Xinyuan-LilyGO/T-Display-P4/firmware/[T-Display-P4][edge_agent]/README.md

# Firmware Modification Log

## 202606021556
### Changed firmware
- `[T-Display-P4_v1.0][edge_agent]_firmware_202606021556`
### Change content
- 更新edge_agent版本

## 202605291655
### Changed firmware
- `[T-Display-P4_v1.0][edge_agent]_firmware_202605291655`
### Change content
- 新增触摸控制

## 202605211541
### Changed firmware
- `[T-Display-P4_v1.0][edge_agent]_firmware_202605211541.bin`
### Change content
- 添加自动识别屏幕类型
- 新增es8311模块、2个i2c总线、1个uart（用于gps gnss）、1个i2s

## 202605080938
### Changed firmware
- `[T-Display-P4_v1.0][edge_agent][hi8561][ov2710]_firmware_202605080938`
- `[T-Display-P4_v1.0][edge_agent][rm69a10][ov2710]_firmware_202605080938`
### Change content
- 初始版本
