Xinyuan-LilyGO/T-Display-P4/firmware/[T-Display-P4-Keyboard][lvgl_9_ui]/README.md

# Firmware Modification Log

## 202604071529
### Changed firmware
- `[T-Display-P4_v1.0][T-Display-P4-Keyboard_v1.0][lvgl_9_ui][hi8561][ov2710]_firmware_202604071529`
- `[T-Display-P4_v1.0][T-Display-P4-Keyboard_v1.0][lvgl_9_ui][rm69a10][ov2710]_firmware_202604071529`
### Change content
- 更新最新测试版本

## 202510230957
### Changed firmware
- `[T-Display-P4-Keyboard][lvgl_9_ui][hi8561][ov2710]_firmware_202510230957`
- `[T-Display-P4-Keyboard][lvgl_9_ui][rm69a10][ov2710]_firmware_202510230957`
### Change content
- 将摄像头ppa操作的输出数据换为独立内存解决摄像头撕裂问题

## 202510151042
### Changed firmware
- `[T-Display-P4-Keyboard][lvgl_9_ui][hi8561][ov2710]_firmware_202510151042`
- `[T-Display-P4-Keyboard][lvgl_9_ui][rm69a10][ov2710]_firmware_202510151042`
### Change content
- 更新esp-idf v5.5.0版本
- 修复摄像头ppa裁剪错误问题
- 添加屏幕旋转使用ppa功能

## 202509261215
### Changed firmware
- `[T-Display-P4-Keyboard][lvgl_9_ui][hi8561][ov2710]_firmware_202509261215`
- `[T-Display-P4-Keyboard][lvgl_9_ui][rm69a10][ov2710]_firmware_202509261215`
### Change content
- 添加系统设备状态通知

## 202509151729
### Changed firmware
- `[T-Display-P4-Keyboard][lvgl_9_ui][hi8561][ov2710]_firmware_202509151729`
- `[T-Display-P4-Keyboard][lvgl_9_ui][rm69a10][ov2710]_firmware_202509151729`
### Change content
- 修改背光驱动芯片pwm频率为20khz，修复键盘背光啸叫声

## 202509101652
### Changed firmware
- `[T-Display-P4-Keyboard][lvgl_9_ui][hi8561][ov2710]_firmware_202509101652`
- `[T-Display-P4-Keyboard][lvgl_9_ui][rm69a10][ov2710]_firmware_202509101652`
### Change content
- 初始版本
