Xinyuan-LilyGO/T-Display-P4/main/examples/lvgl_9_ui/resource/t_display_p4_lvgl_9_ui_resource/music cover/Eagles - Hotel California (Live on MTV, 1994)_568x1232px.png

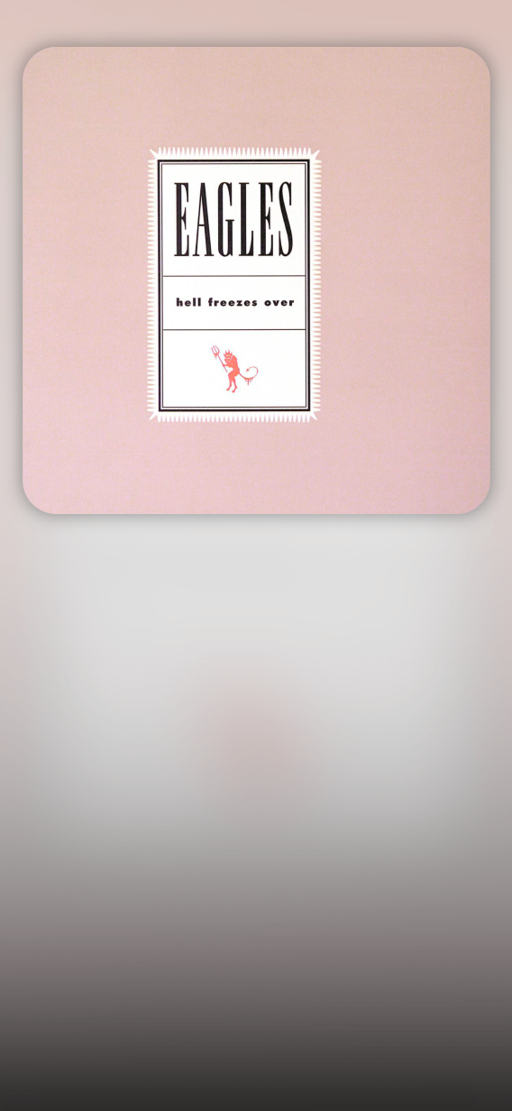
main/examples/lvgl_9_ui/resource/t_display_p4_lvgl_9_ui_resource/music cover/Eagles - Hotel California (Live on MTV, 1994)_568x1232px.png
