Xinyuan-LilyGO/T-Display-P4/main/examples/lvgl_9_ui/resource/t_display_p4_lvgl_9_ui_resource/wallpaper/wallpaper_3_540x1168px.png

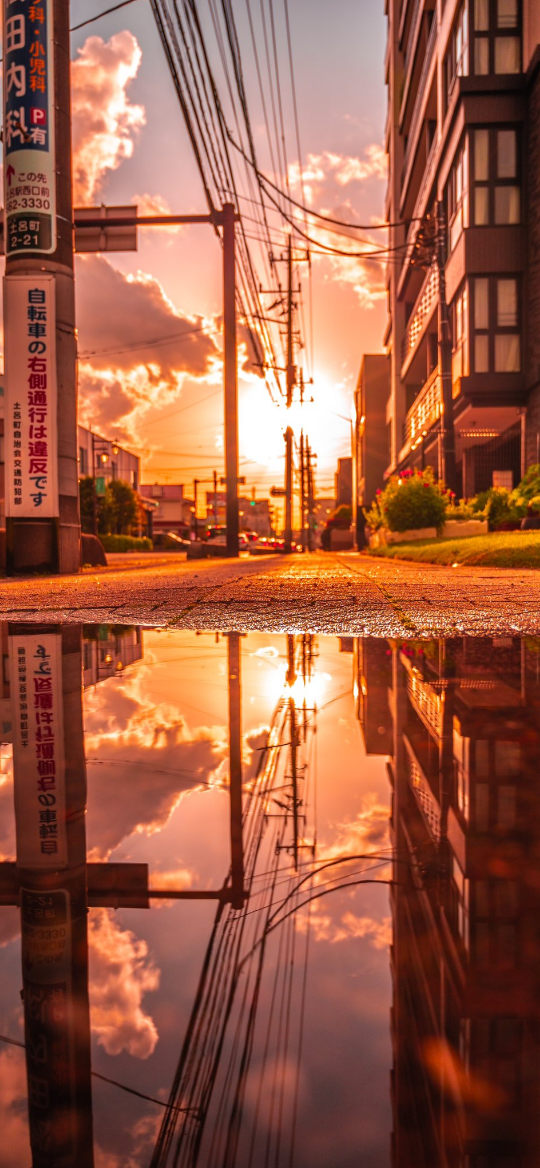
main/examples/lvgl_9_ui/resource/t_display_p4_lvgl_9_ui_resource/wallpaper/wallpaper_3_540x1168px.png
