Xinyuan-LilyGO/T-Display-P4/structure/K270.stp

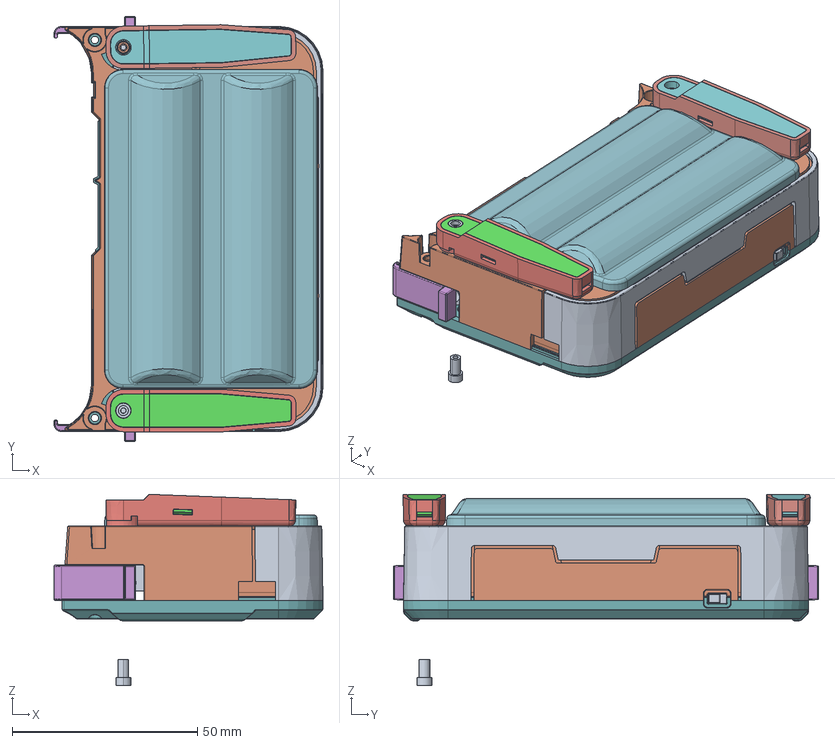
[picture p16: CAD file, 2026-11-02]
structure/K270.stp
72.6 x 114.7 x 51.6 mm
0-ALL_ASM_281_ASM_2_ASM_3_ASM_2_ASM
TOPCOPPER_TGVZ_1
BOTTOMCOPPER_TGVZ_1
TOPFPCSTIFFENER_TGVZ_1
BOTTOMFPCSTIFFENER_TGVZ_1
ANT-TH_KH-MMCX-KWE_MMCX-SMD_KH-_ASM
TOPCOPPER_TGVZ_1_1
BOTTOMCOPPER_TGVZ_1_1
TOPFPCSTIFFENER_TGVZ_1_1
BOTTOMFPCSTIFFENER_TGVZ_1_1
ANT-TH_KH-MMCX-KWE_MMCX-SMD__15_ASM
0-0019_ASM
020001_14_MIR_5_3
020002_12_MIR_2_5
