Xinyuan-LilyGO/T-Display-P4/structure/K270-STL/0-00.stl

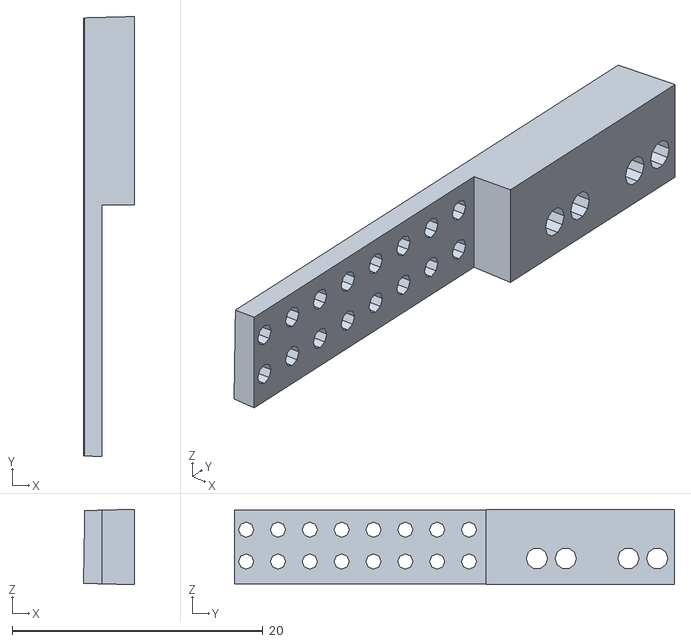
[picture p17: CAD file, 2026-11-02]
structure/K270-STL/0-00.stl
4.07 x 35.1 x 6.02
