Xinyuan-LilyGO/T-Display-P4/structure/T-Display-P4_V1.0_PCB.dxf

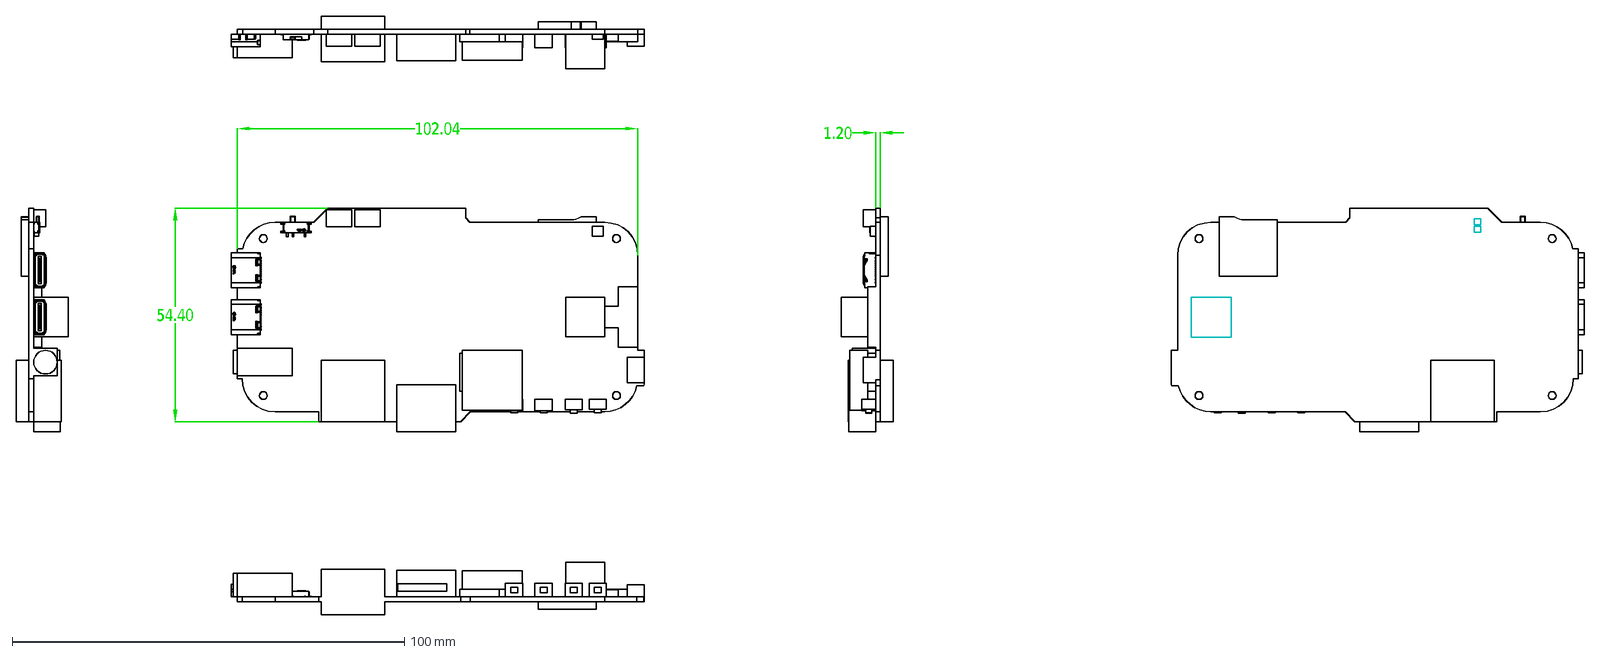
[picture p18: CAD file, 2026-10-16]
structure/T-Display-P4_V1.0_PCB.dxf
102.04
54.40
1.20
