Xinyuan-LilyGO/T-Display-P4/structure/H753.stp

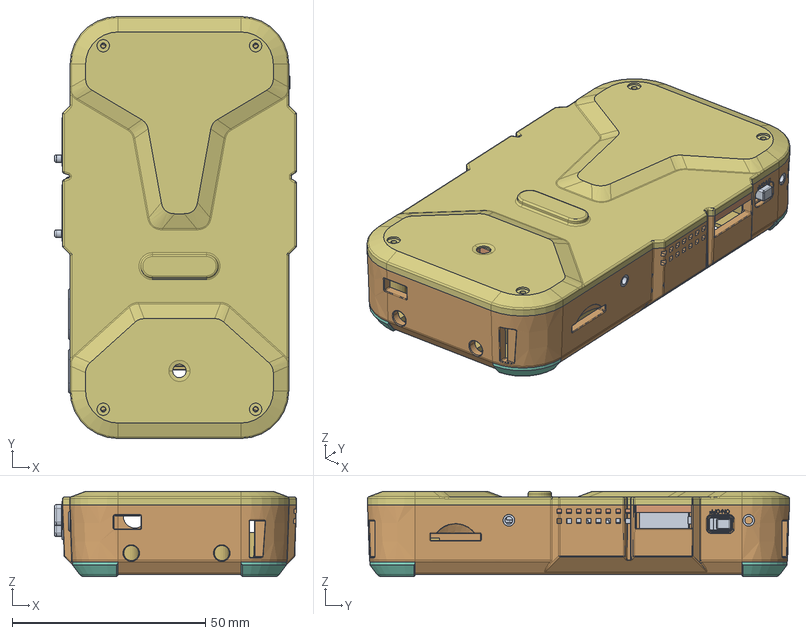
[picture p19: CAD file, 2026-06-24]
structure/H753.stp
62.6 x 109.1 x 22.1 mm
0-KEY_49_4_2_2_16
ADMI0DC85E9FFMCY_1_3
ADMI0DC85E9FFMCY_2_1
ADMI0DC85E9FFMCY_3_1
ADMI0DC85E9FFMCY_4_1
ADMI0DC85E9FFMCY_5_1
ADMI0DC85E9FFMCY_6_1
ADMI0DC85E9FFMCY_7_1
