Xinyuan-LilyGO/T-Display-P4/structure/K270-STL/0-00_16_2.stl

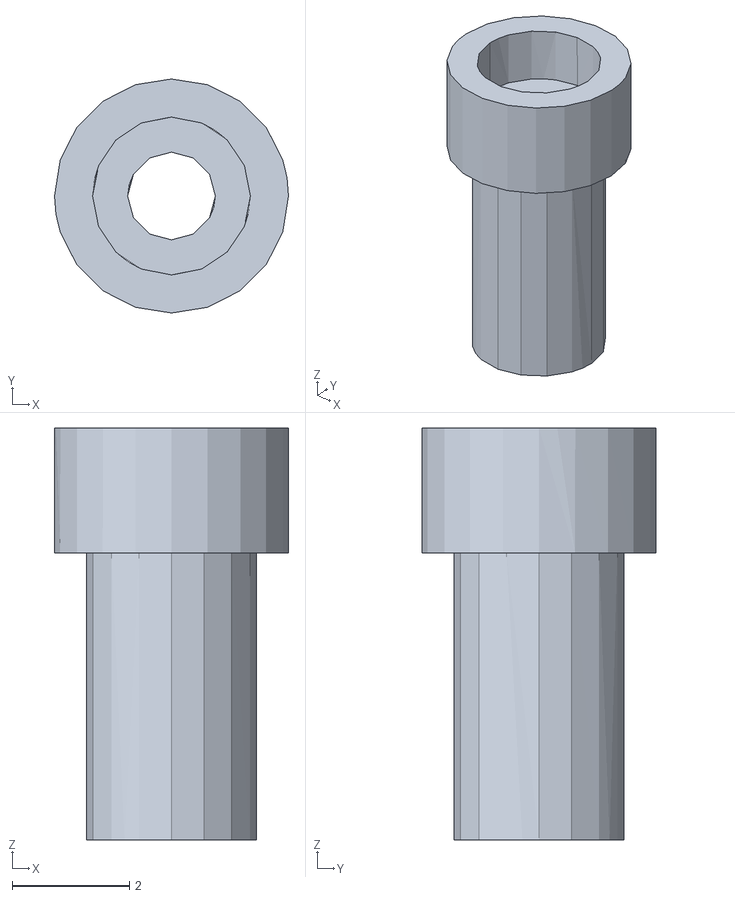
[picture p20: CAD file, 2026-11-02]
structure/K270-STL/0-00_16_2.stl
4.00 x 4.00 x 7.04
