Xinyuan-LilyGO/T-Display-P4/structure/K270-STL/0-0_9_11_1.stl

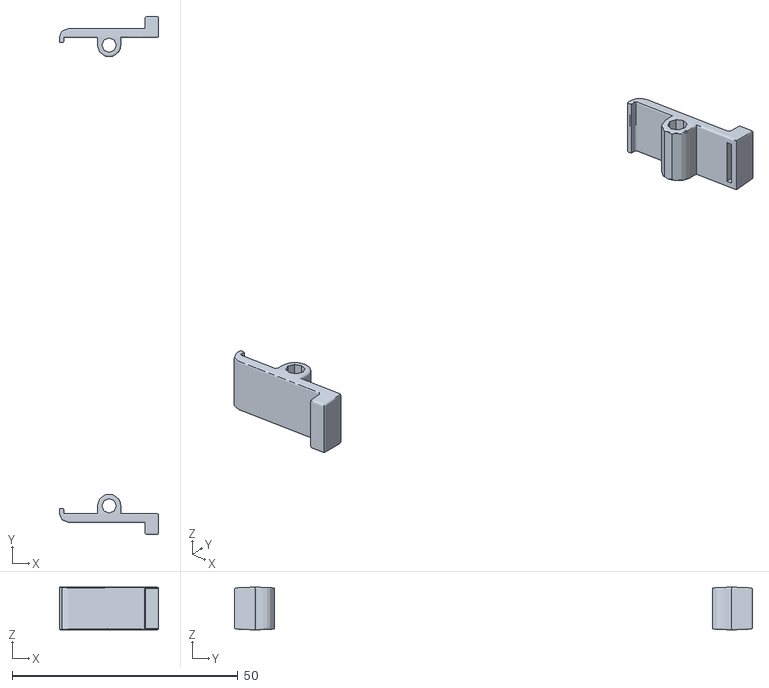
[picture p21: CAD file, 2026-11-02]
structure/K270-STL/0-0_9_11_1.stl
22.0 x 114.7 x 9.51
