Xinyuan-LilyGO/T-Display-P4/structure/K270-STL/0-0006.stl

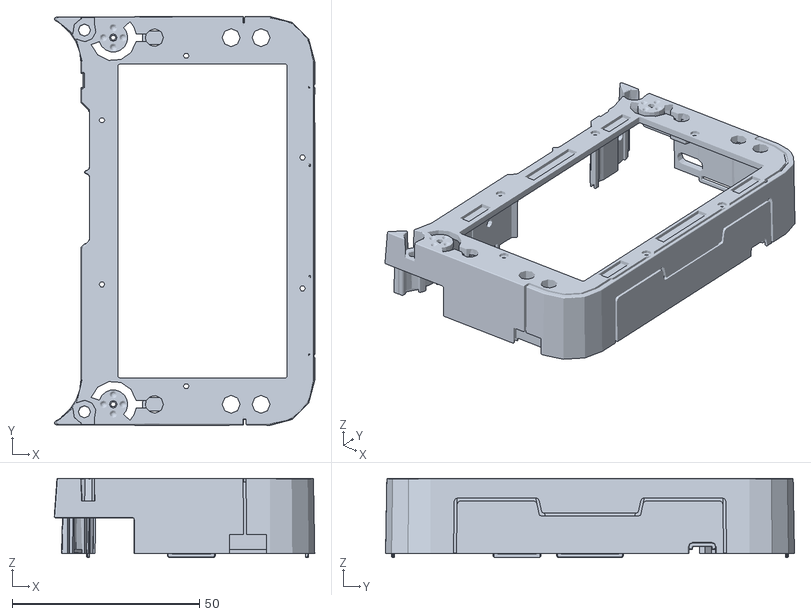
[picture p22: CAD file, 2026-11-02]
structure/K270-STL/0-0006.stl
69.6 x 109.3 x 21.2
