Xinyuan-LilyGO/T-Display-P4/structure/K270-STL/0-0003.stl

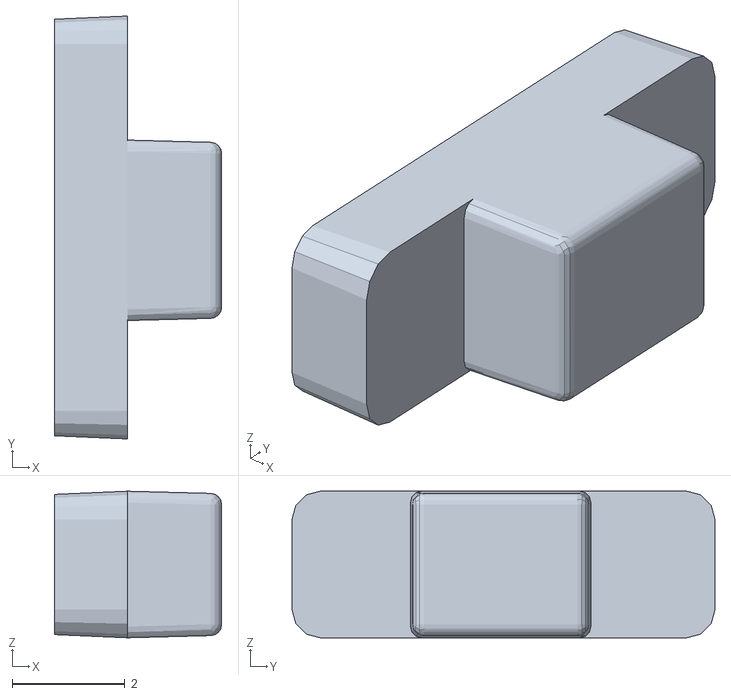
[picture p23: CAD file, 2026-11-02]
structure/K270-STL/0-0003.stl
2.97 x 7.50 x 2.60
