Xinyuan-LilyGO/T-Display-P4/structure/K270-STL/0-0001.stl

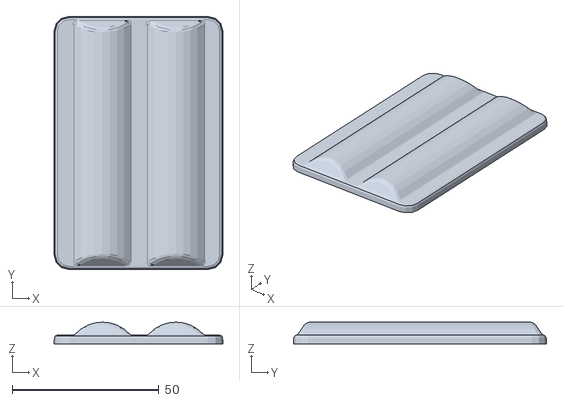
[picture p24: CAD file, 2026-11-02]
structure/K270-STL/0-0001.stl
57.5 x 86.1 x 7.42
