Xinyuan-LilyGO/T-Display-P4/structure/K270-STL/0-0002.stl

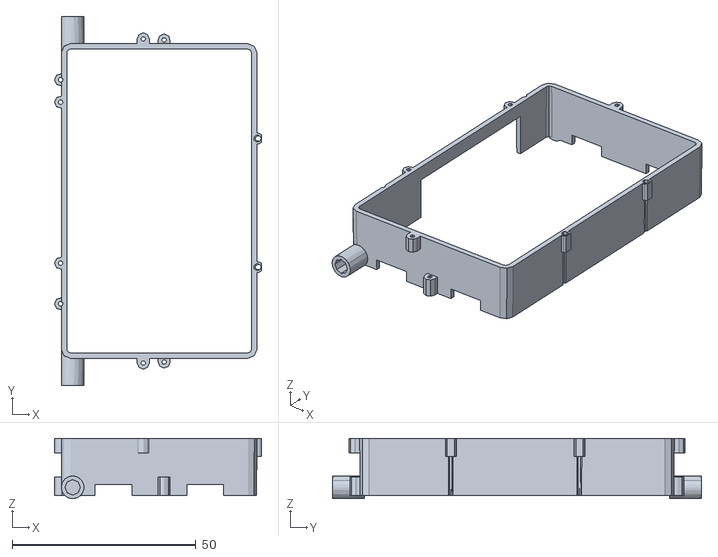
[picture p25: CAD file, 2026-11-02]
structure/K270-STL/0-0002.stl
56.4 x 100.5 x 16.5
