Xinyuan-LilyGO/T-Display-P4/structure/K270-STL/0-000.stl

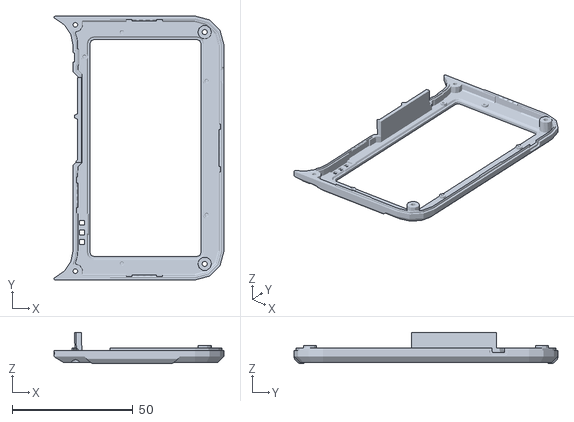
[picture p26: CAD file, 2026-11-02]
structure/K270-STL/0-000.stl
70.4 x 109.3 x 12.9
