Xinyuan-LilyGO/T-Display-P4/structure/K270-STL/020002_12_2_3.stl

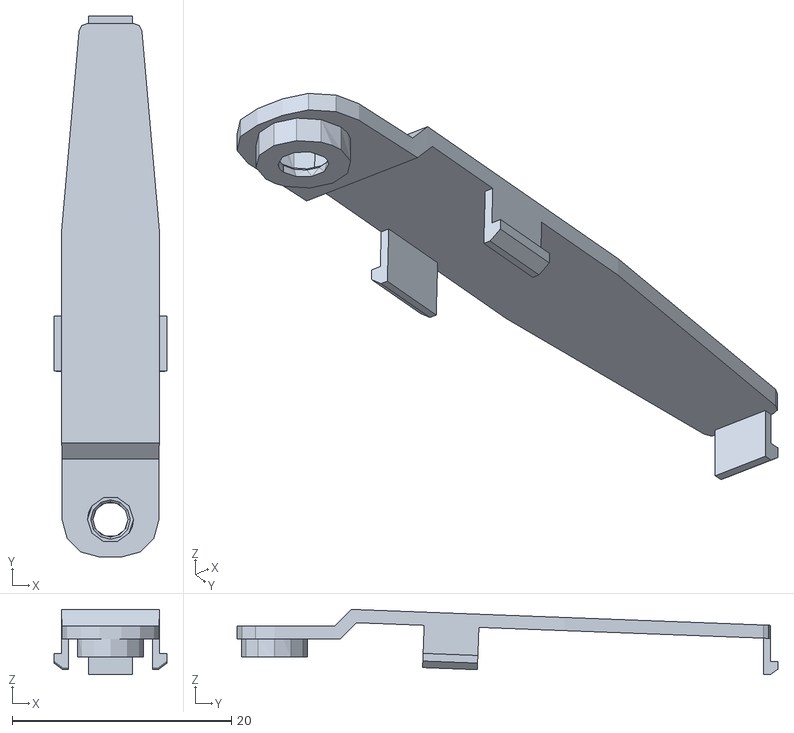
[picture p27: CAD file, 2026-11-02]
structure/K270-STL/020002_12_2_3.stl
10.3 x 49.3 x 5.95
