Xinyuan-LilyGO/T-Display-P4/structure/K270-STL/020001_14_17_5.stl

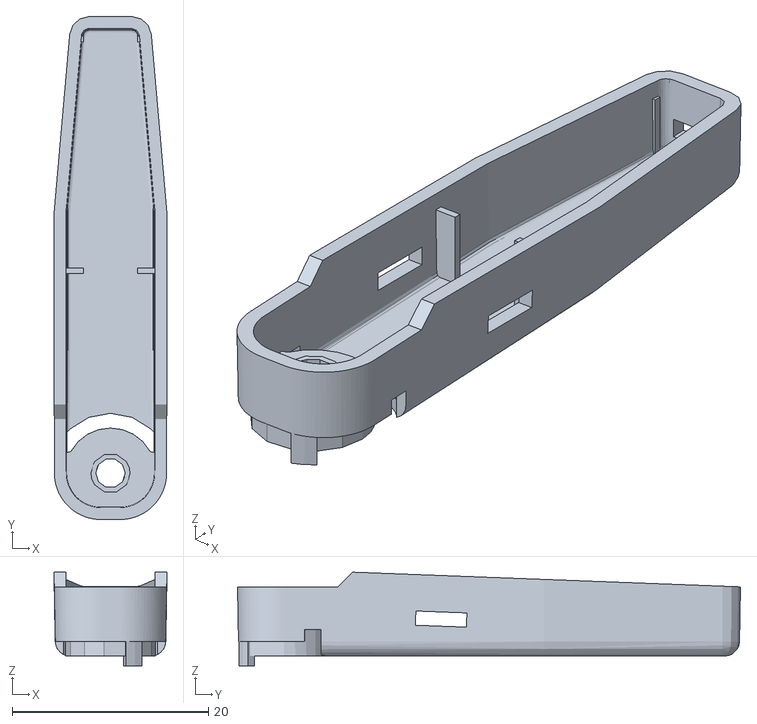
[picture p28: CAD file, 2026-11-02]
structure/K270-STL/020001_14_17_5.stl
11.5 x 51.2 x 9.54
