Xinyuan-LilyGO/T-Display-P4/(list of files, cad)

Other CAD files:
structure/K270-STL/0-00_16_1.stl
structure/K270-STL/020002_12_mir_2_5.stl
structure/K270-STL/020001_14_mir_5_3.stl
