Xinyuan-LilyGO/T-Display-P4/(threads)

Thread 2 (2025-08-14):

GNSS PPS signal is missing

lyusupov, 2025-08-14:
### Operating System

any

### IDE

any

### Software Package Version

current

### Description

PPS signal was available in previous versions of `t_display_p4_config.h`
but now it is not in there..

PPS signal is a crucial feature for precise timing synchronization with atomic clocks located on the satellites.

### Sketch

```cpp
any
```

### Debug Message

```plain
any
```

### Other steps to Reproduce

_No response_

lyusupov, 2025-08-14:
> because the ESP32-P4 has insufficient pins,

it does not look like a good argument because you use XL9535 GPIO extender anyway...

https://github.com/search?q=repo%3AXinyuan-LilyGO%2FT-Display-P4%20PPS&type=code

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

Llgok, 2025-08-14:
@lyusupov
The `debug` directory contains programs used for debugging purposes, and their completeness cannot be guaranteed. The latest pin configuration is available in [t_display_p4_config.h](https://github.com/Xinyuan-LilyGO/T-Display-P4/blob/main/components/private_library/t_display_p4_config.h).

We did previously have the PPS pin connected, but all available pins on both the ESP32-P4 and XL9535 were allocated to more critical interfaces, which is why the PPS pin was ultimately removed.

This is the PCB designed by our hardware engineer. You can take a look at it.

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

lyusupov, 2025-08-14:
> We did previously have the PPS pin connected, but all available pins on both the ESP32-P4 and XL9535 were allocated to more critical interfaces, which is why the PPS pin was ultimately removed.

An approach to exhaust every resource available is not very smart one.
A **properly designed system** should keep approx..  25% of resources, such as
- CPU power
- FLASH
- RAM
- pins
- power supply
- etc...

**reserved** for a future use to apply

- fixes
- improvements
- upgrades

Closed 2025-08-14.
