Xinyuan-LilyGO/T-Display-P4/project/T-Display-P4_v2.0(Evaluation Preview)_202610161400.pdf

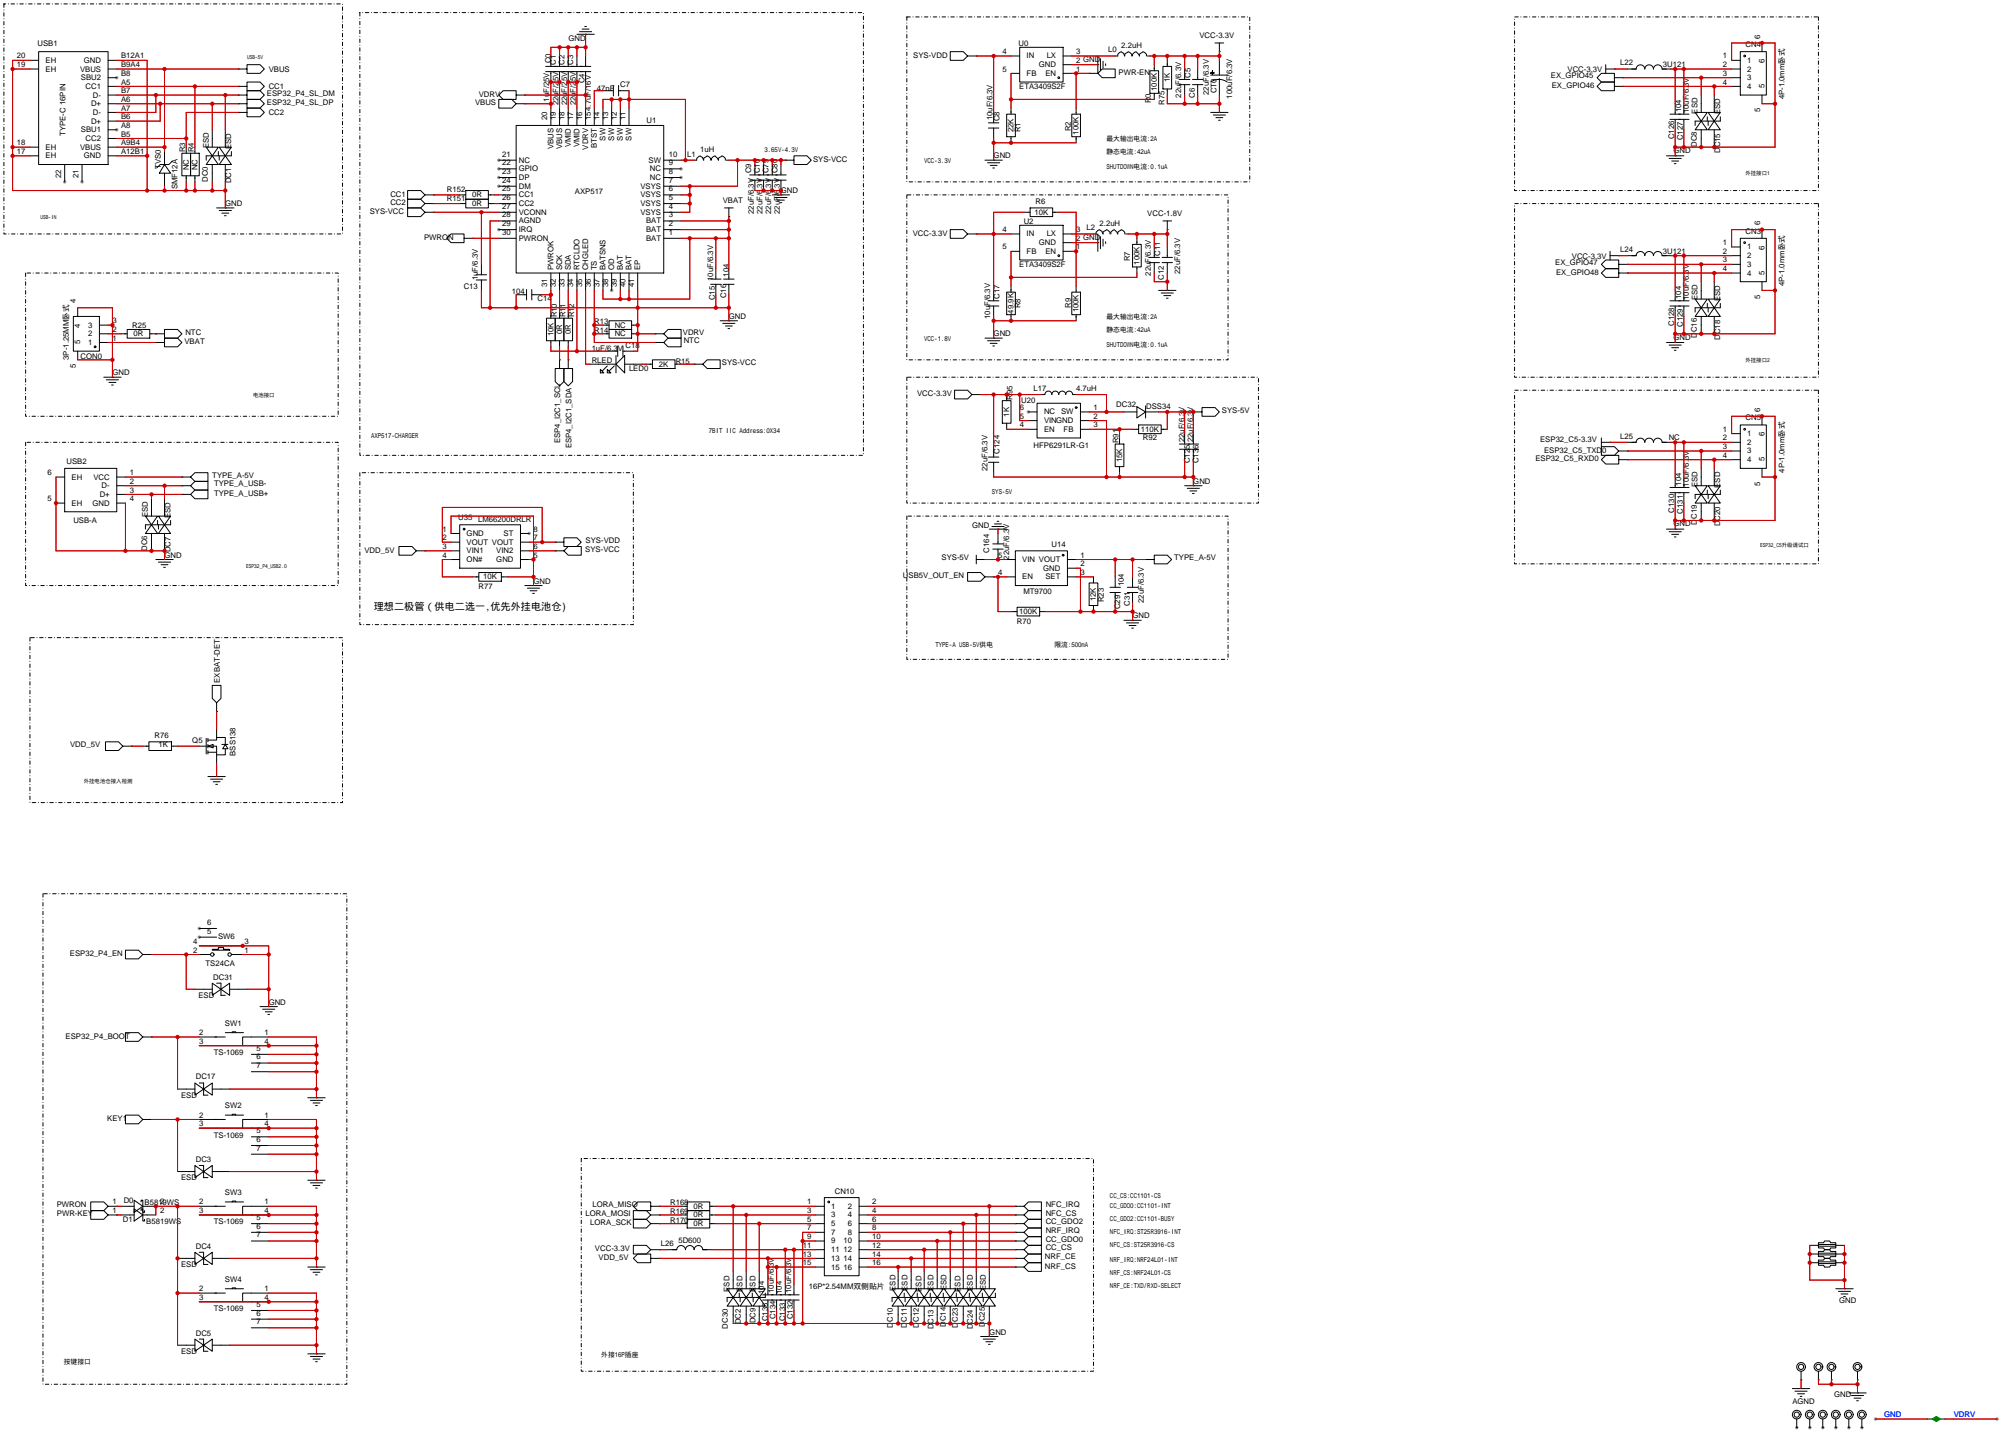
[picture p32: page 1]

## 10KR¹⁴⁴ ¹⁰K

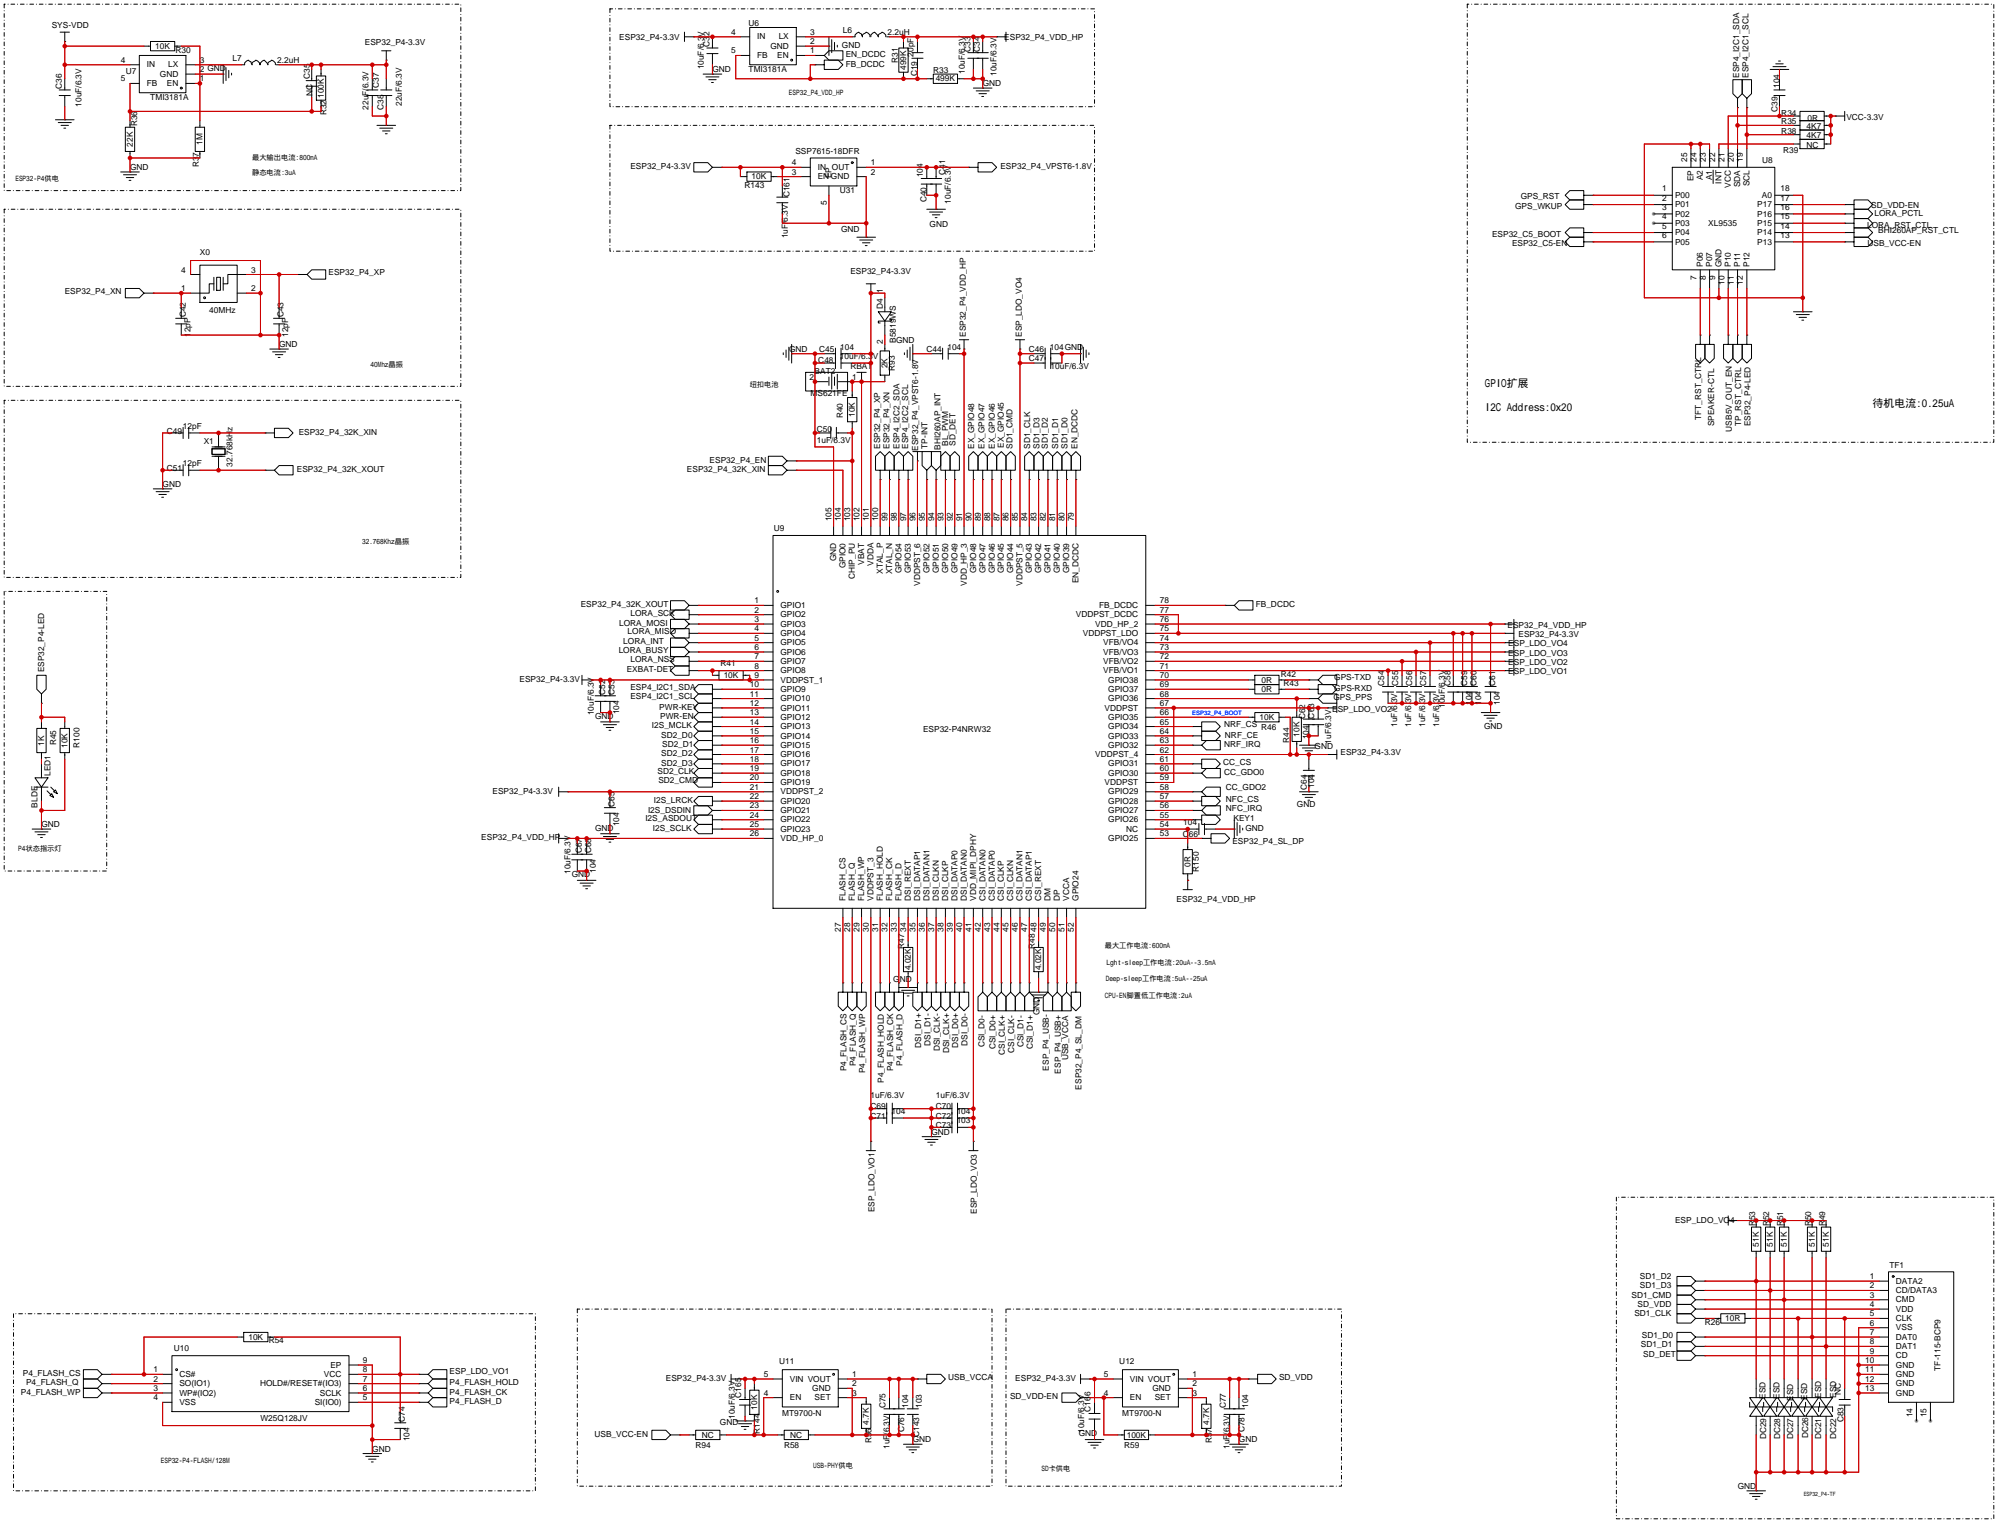
[picture p33: page 2]

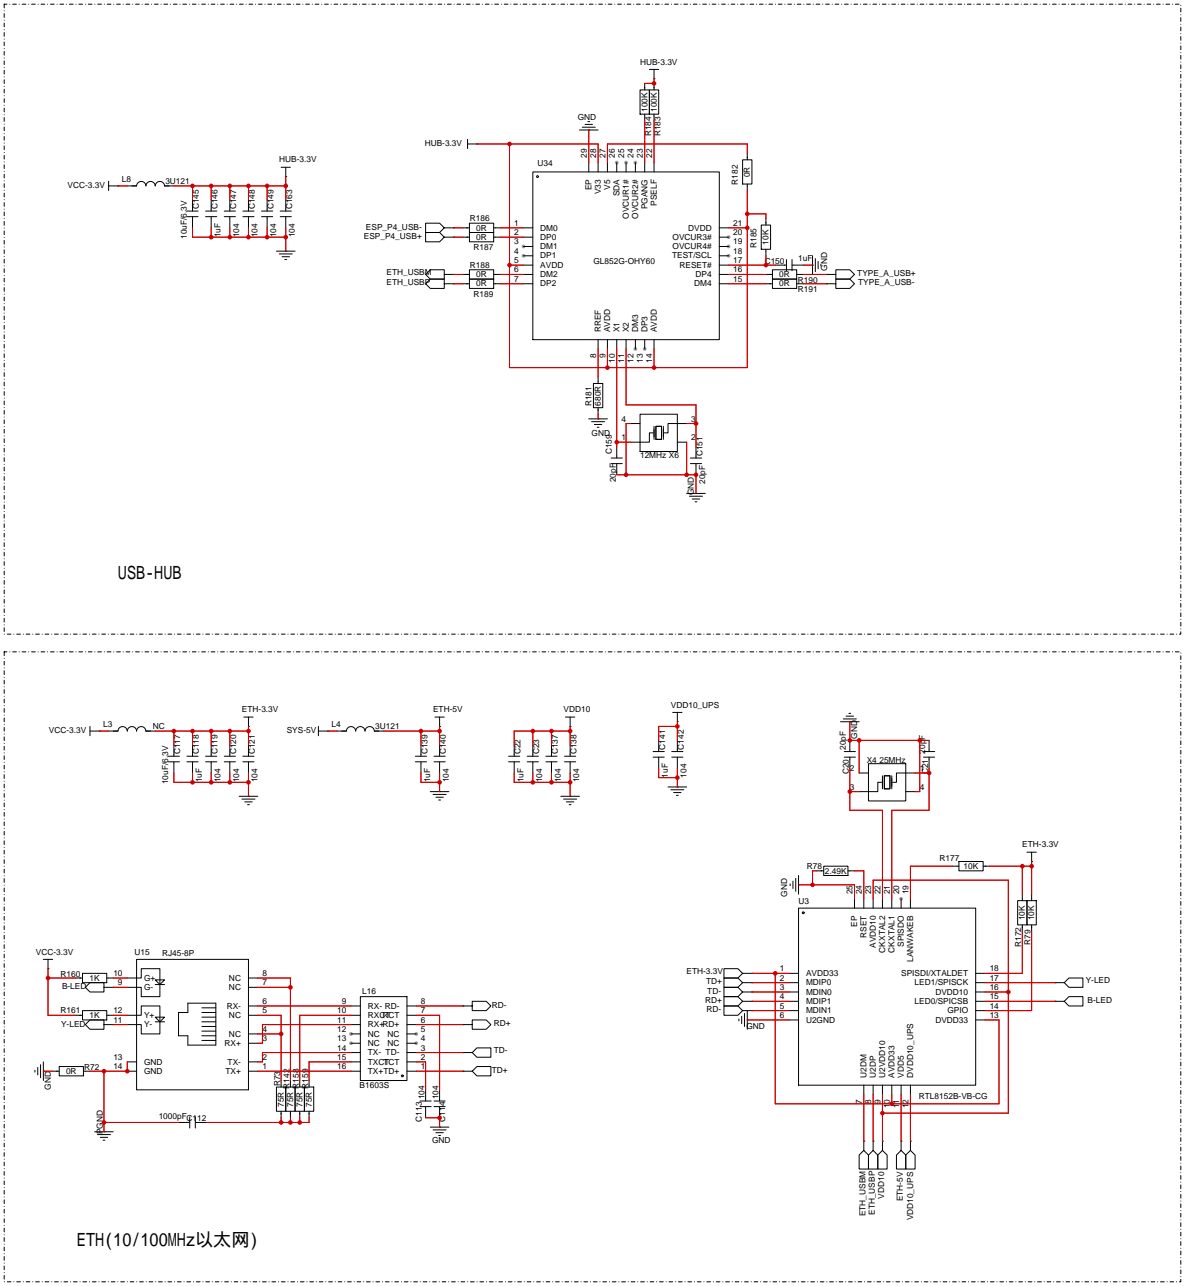
[picture p34: page 3]

PSELF 22 PGANG 23 OVCUR2# 24 OVCUR1# 25 SDA 26 V5 27 V33 28 EP 29

L46 | 22uH | 1 D3 | B5819WS 2 C²³⁵ ¹⁰uF/6.3V

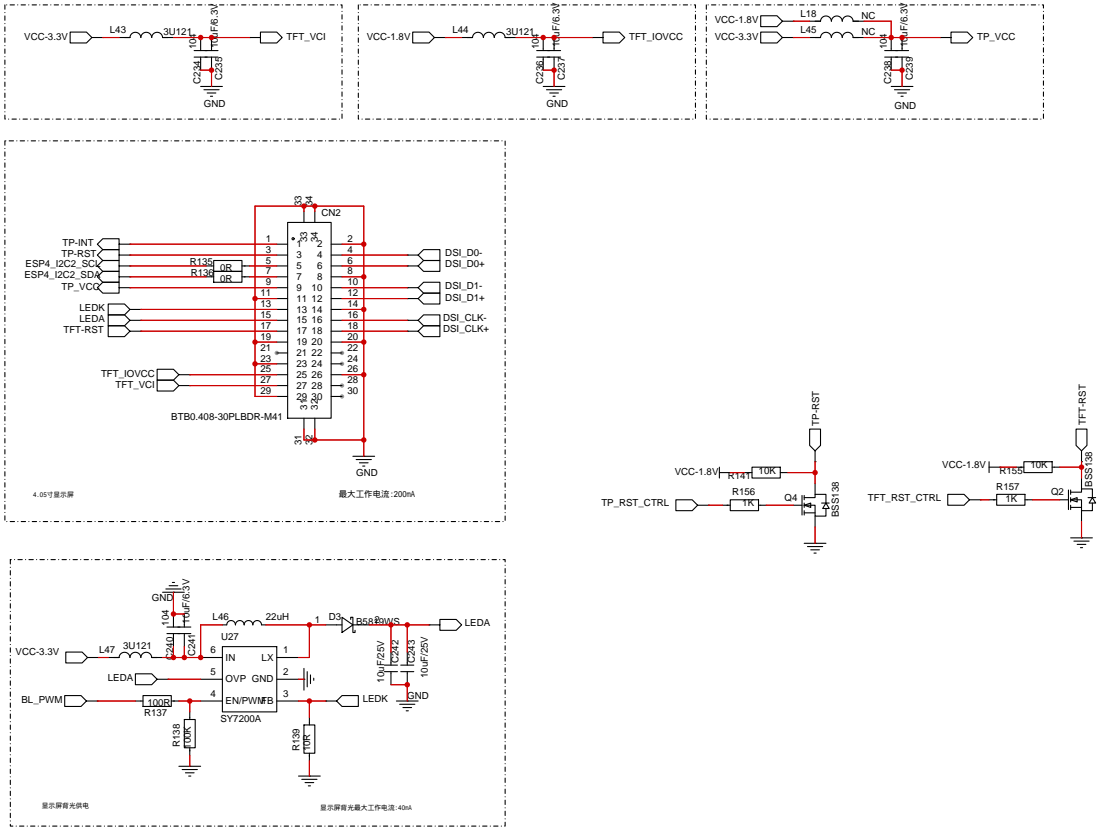
[picture p35: page 4]

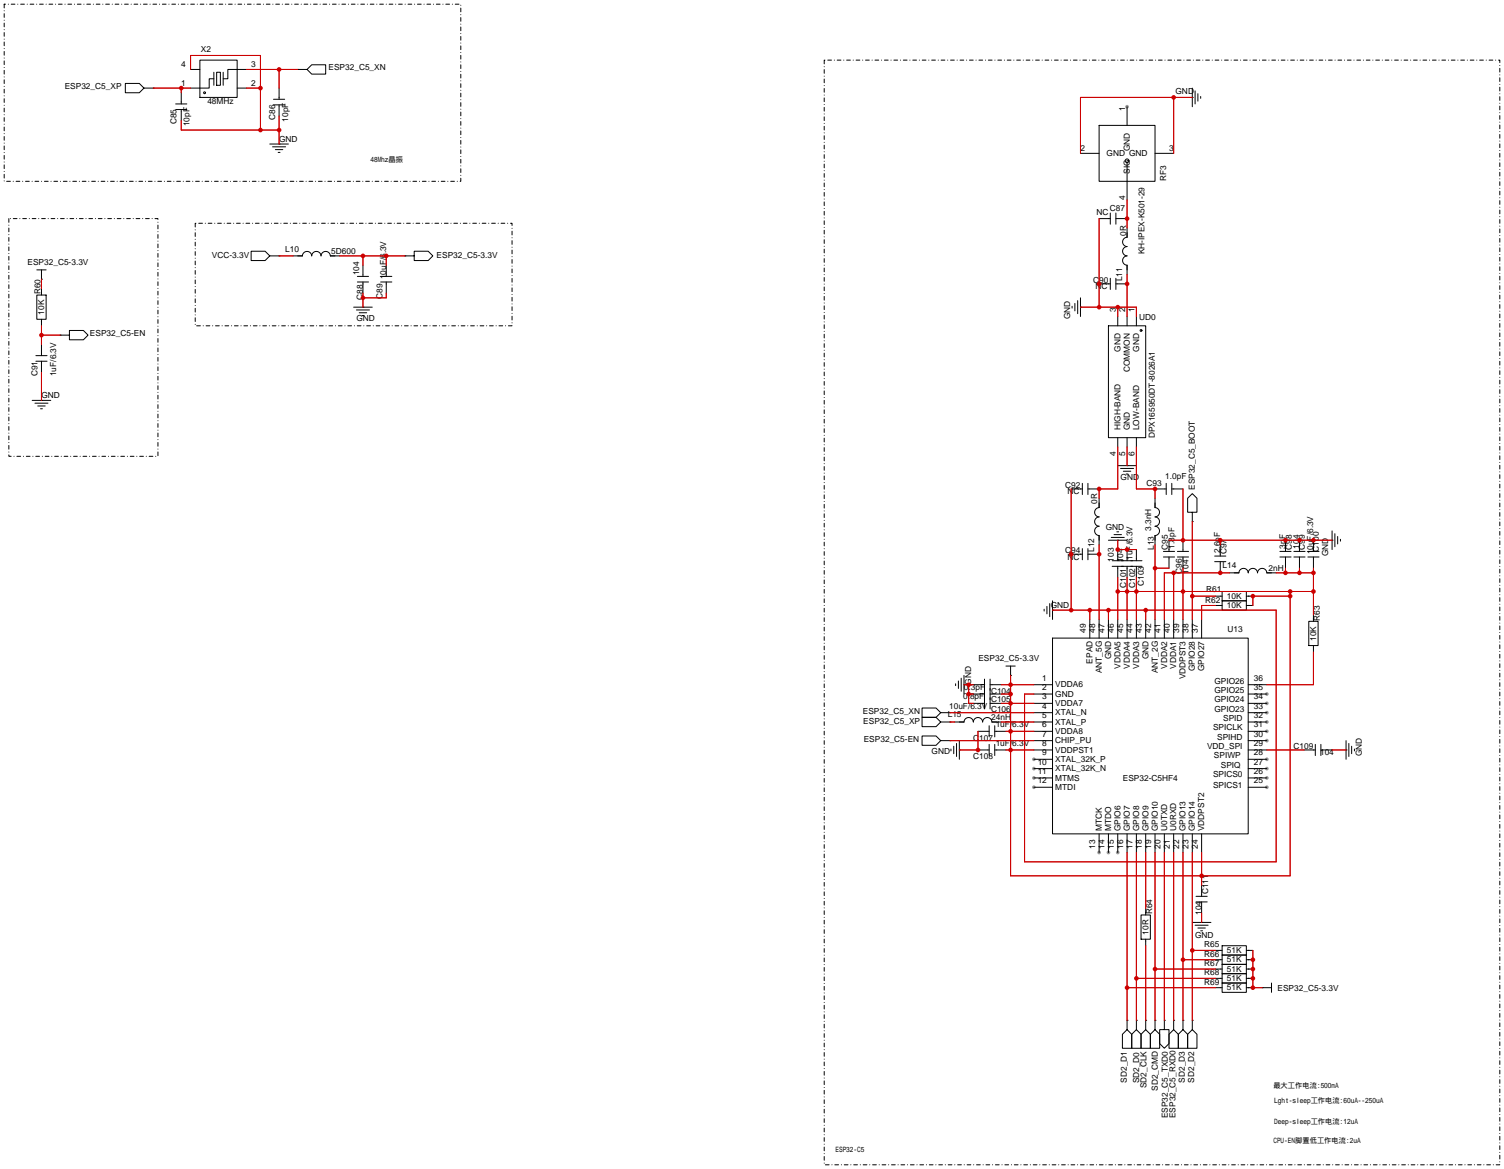
[picture p36: page 5]

GND 1 COMMON 2 GND 3 HIGH-BAND 4 GND 5 LOW-BAND 6

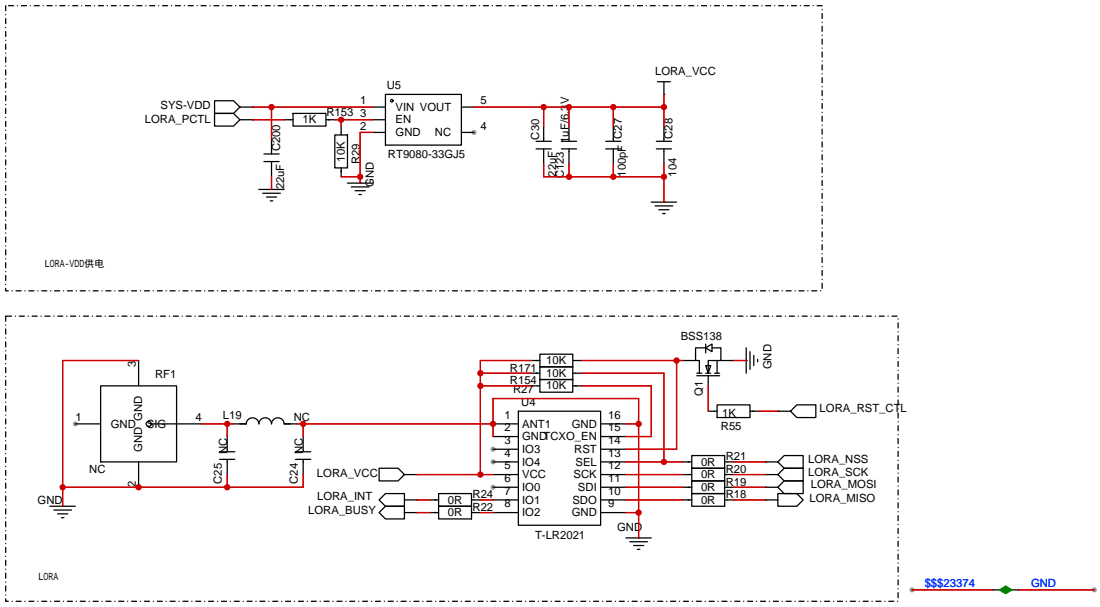
[picture p37: page 6]

## 10KC¹⁶⁰

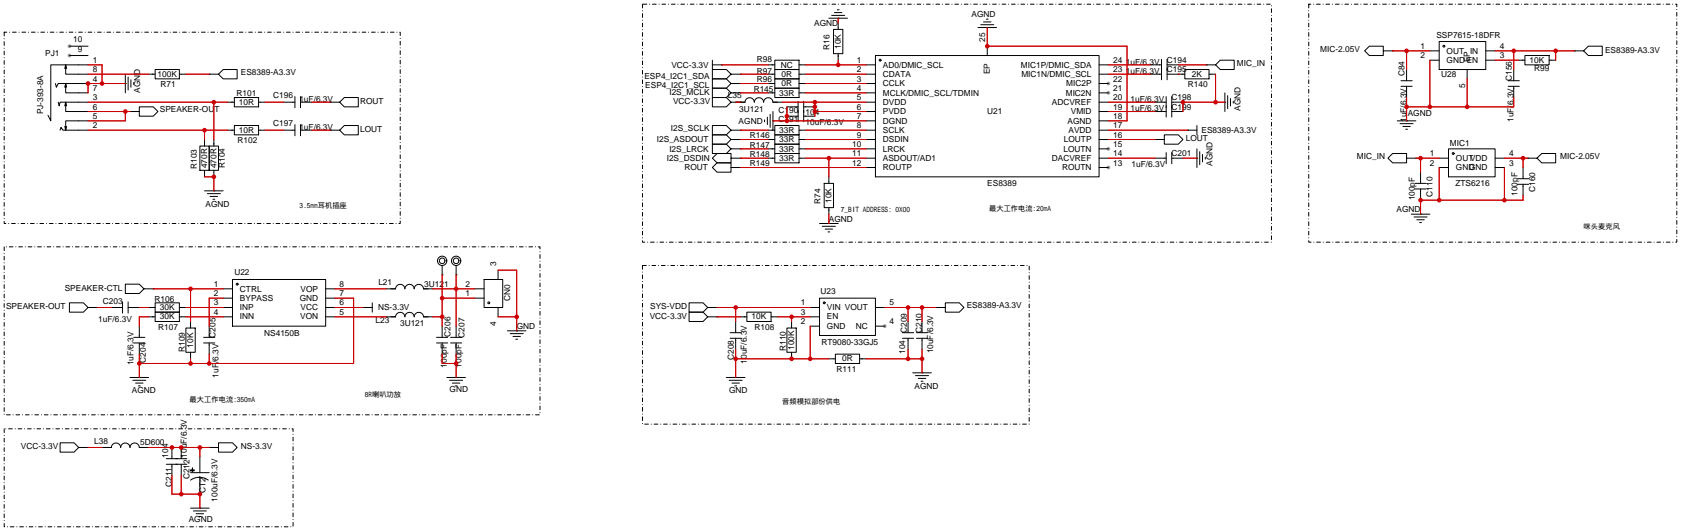
[picture p38: page 7]

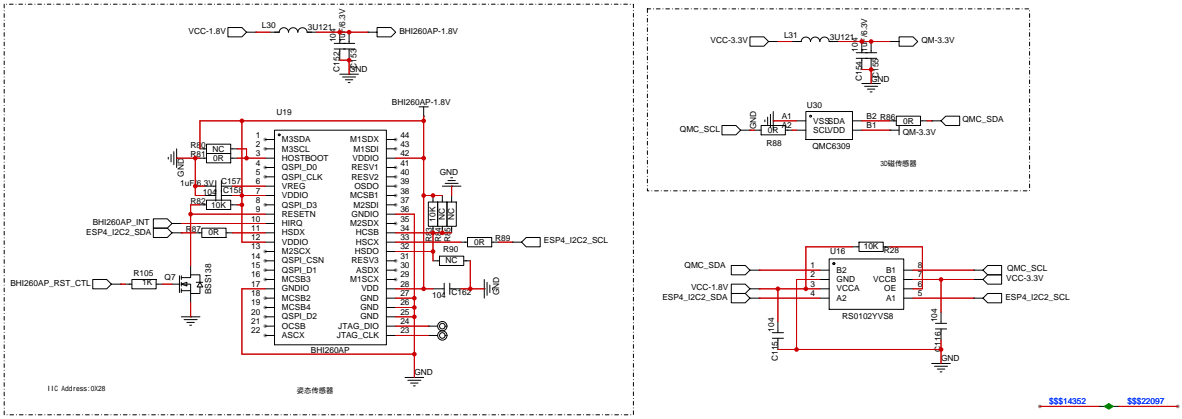
[picture p39: page 8]

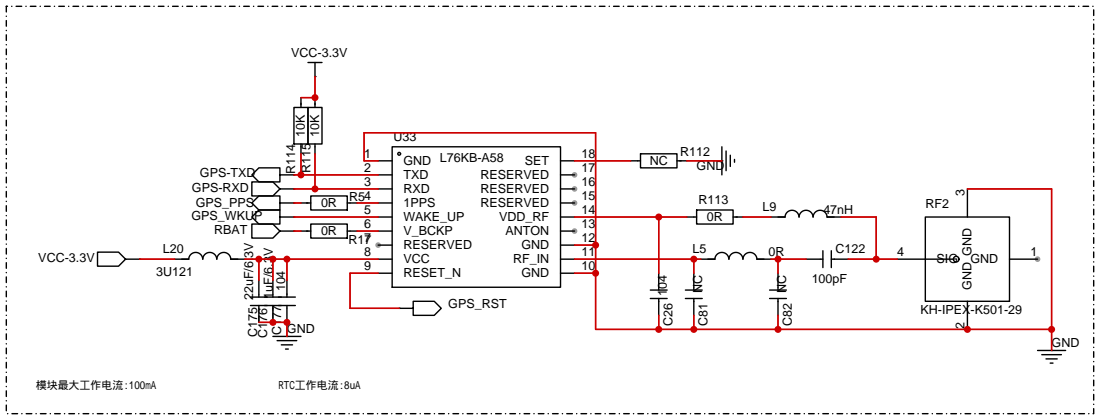
[picture p40: page 9]

# R122 NC R¹²⁵ ⁵¹K

10 | 10 11 | 11 12 | 12 13 | 13 14 | 14 15 | 15 16 | 16 17 | 17 18 | 18 19 | 19 20 | 20 21 | 21 22 | 22 23 | 23 24 | 24

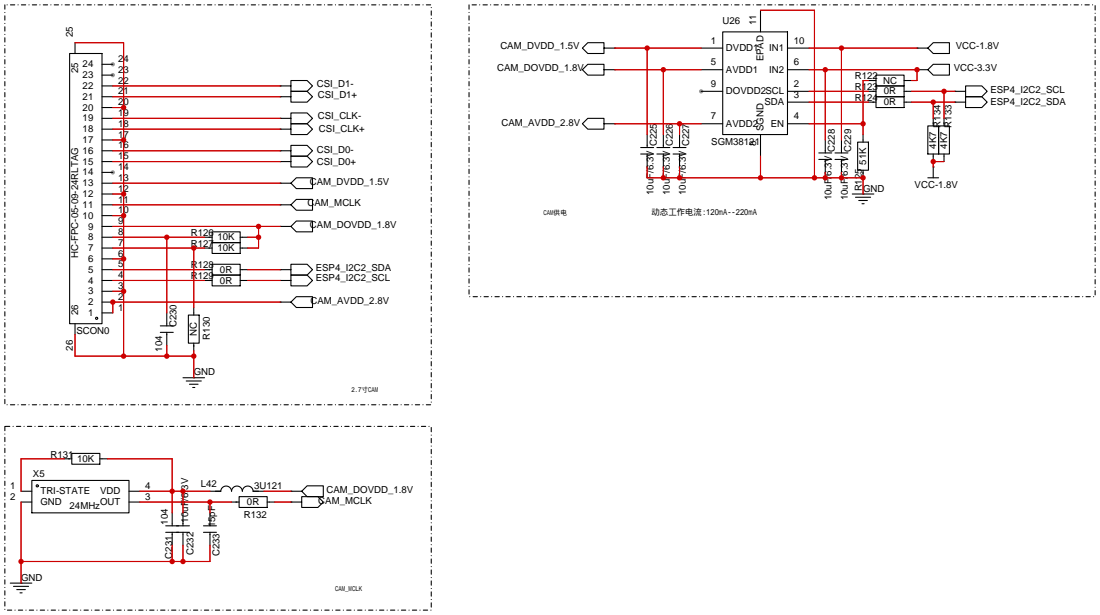
[picture p41: page 10]

SCON0 HC⁻FPC⁻⁰⁵⁻⁰⁹⁻²⁴RLTAG

# AW86224AFCRC²²⁰ ¹⁰uF/6.3V C²¹⁹ ¹⁰⁴

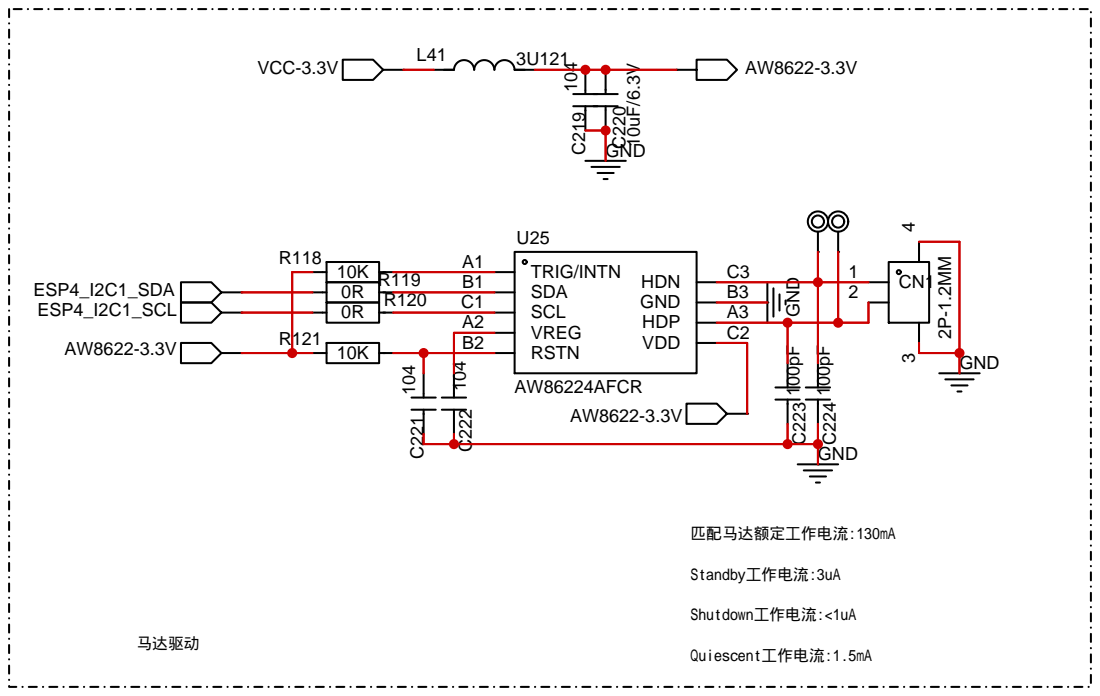
[picture p42: page 11]

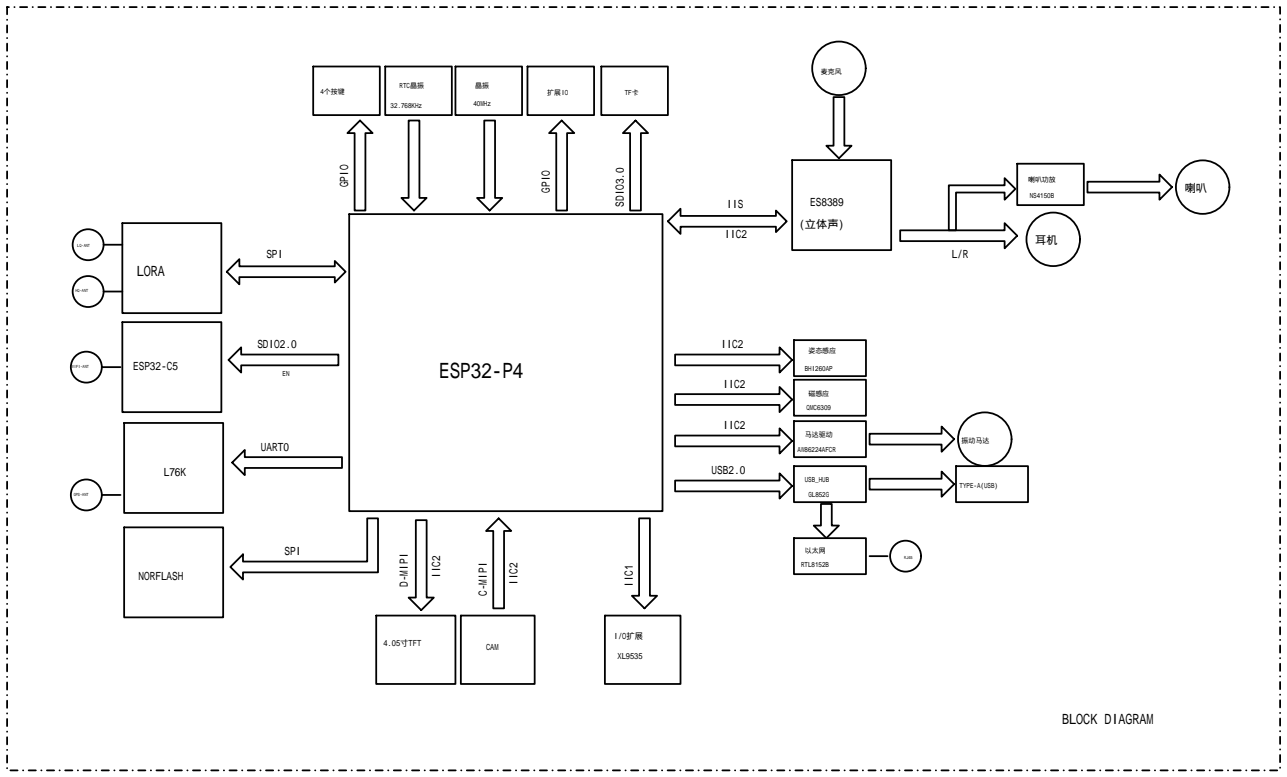
[picture p43: figure]
ESP32-P4; LORA; SPI; ESP32-C5; SDIO2.0; UART0; NORFLASH; 4.05寸TFT; CAM; (立体声); IIS; 喇叭功放; 麦克风; 扩展IO; TF卡; 40MHz 32.768KHz; 4个按键; BHI260AP; QMC6309; AW86224AFCR; RTL8152B; 振动马达; 马达驱动; 以太网; 磁感应; 姿态感应; RTC晶振; GPS-ANT; WIFI-ANT; LQ-ANT; HQ-ANT; I/O扩展; USB2.0; IIC2; BLOCK DIAGRAM; USB_HUB; TYPE-A(USB)
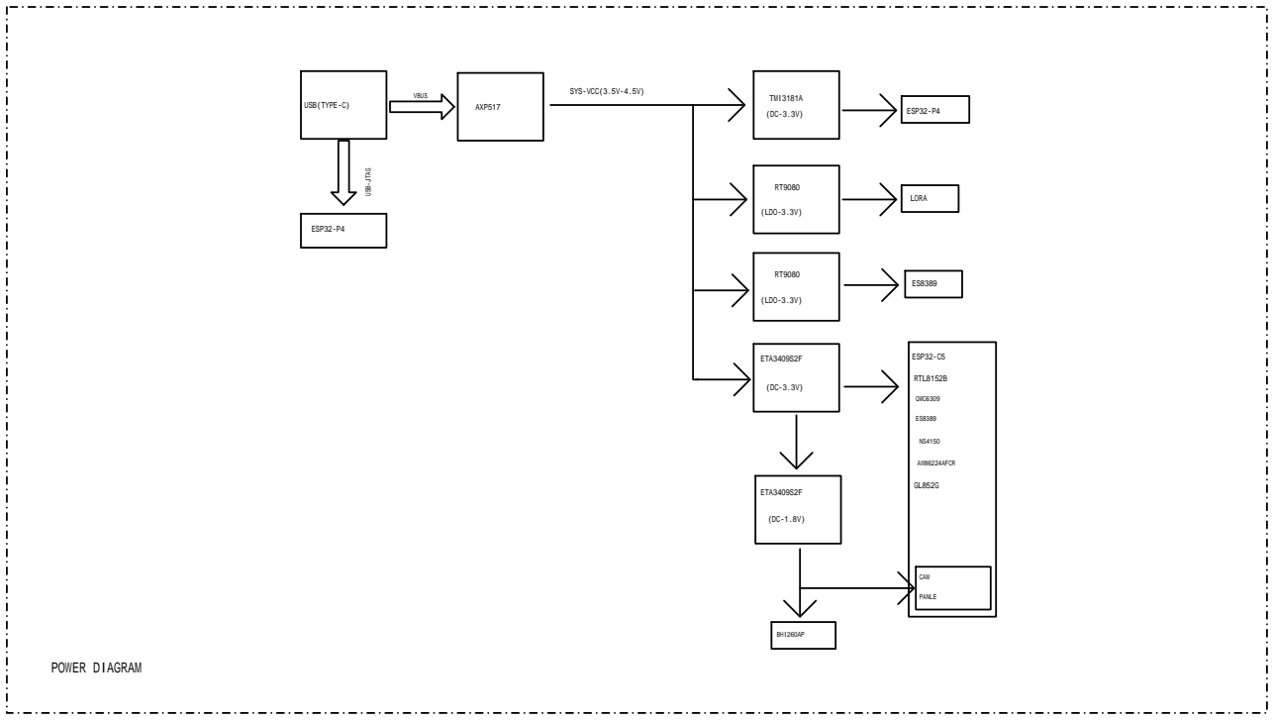
[picture p44: figure]
USB(TYPE-C); AXP517; VBUS; SYS-VCC(3.5V-4.5V); TMI3181A; ETA3409S2F; (LDO-3.3V); LORA; ESP32-P4; ESP32-C5; RTL8152B; BHI260AP; QMC6309; AW86224AFCR; CAM; PANLE; POWER DIAGRAM
