Xinyuan-LilyGO/T-Display-P4/project/T-Display-P4_v2.0(Evaluation Preview)_202605221021.pdf

# ESP32-P4

## LORA

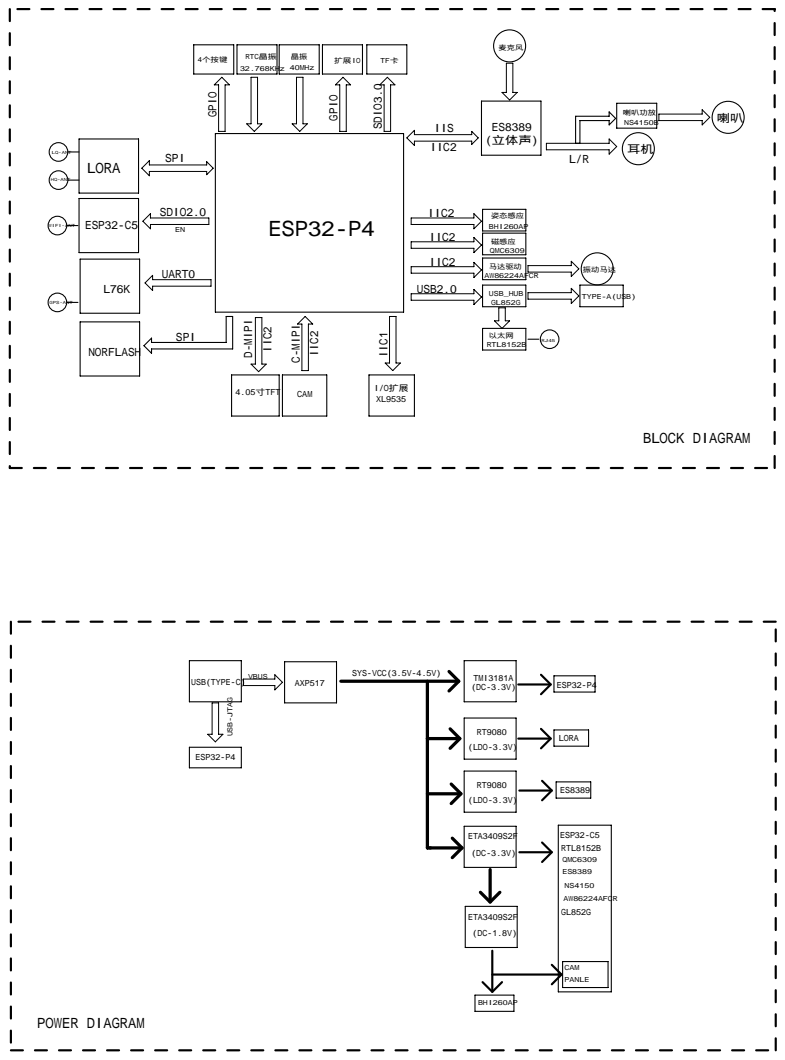
[picture p45: page 1]
SPI; ESP32-C5; SDIO2.0; UART0; NORFLASH; 4.05寸TFT; CAM; ES8389 (立体声); IIS; 喇叭功放; 麦克风; 扩展IO; TF卡; 32.768KHz 40MHz; 4个按键; BHI260AP; QMC6309; AW86224AFCR; RTL8152B; 振动马达; 马达驱动; 以太网; 磁感应; 姿态感应; RTC晶振; GPS-ANT; WIFI-ANT; LQ-ANT; HQ-ANT; I/O扩展; USB2.0; IIC2; USB(TYPE-C); AXP517; VBUS; SYS-VCC(3.5V-4.5V); TMI3181A (DC-3.3V); ETA3409S2F; (LDO-3.3V); LORA; ESP32-P4; PANLE; BLOCK DIAGRAM; POWER DIAGRAM; USB_HUB; TYPE-A(USB)

## VCC-3.3V

# 最大输出电流:2A

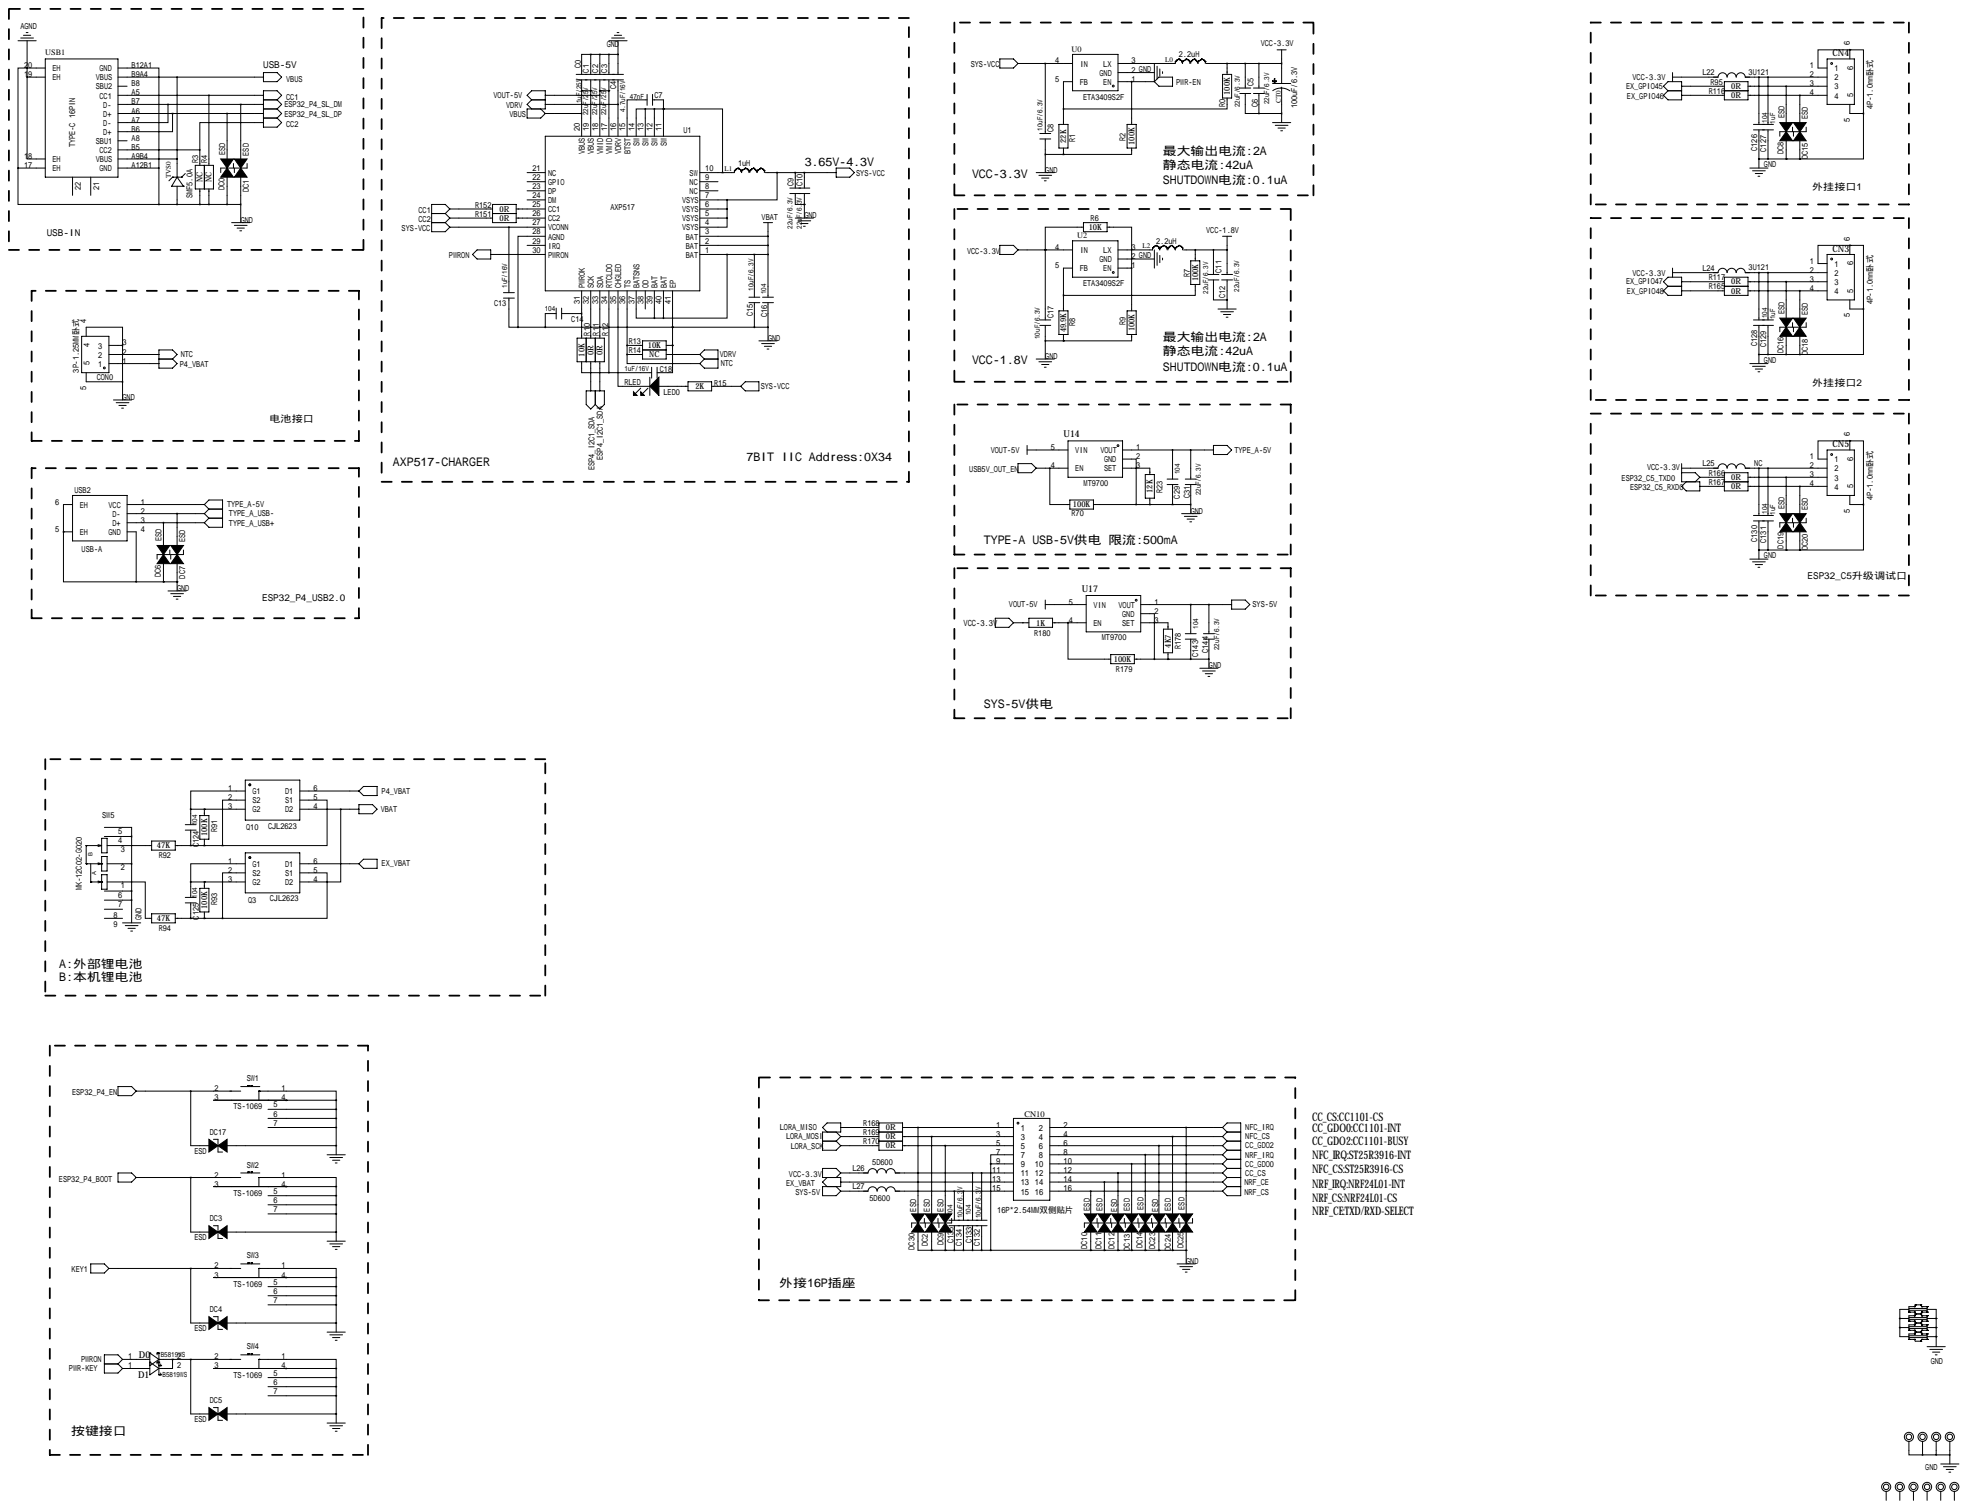
[picture p46: page 2]

GND

GND 电池接口

## ESP32-P4供电

## 最大输出电流:800mA

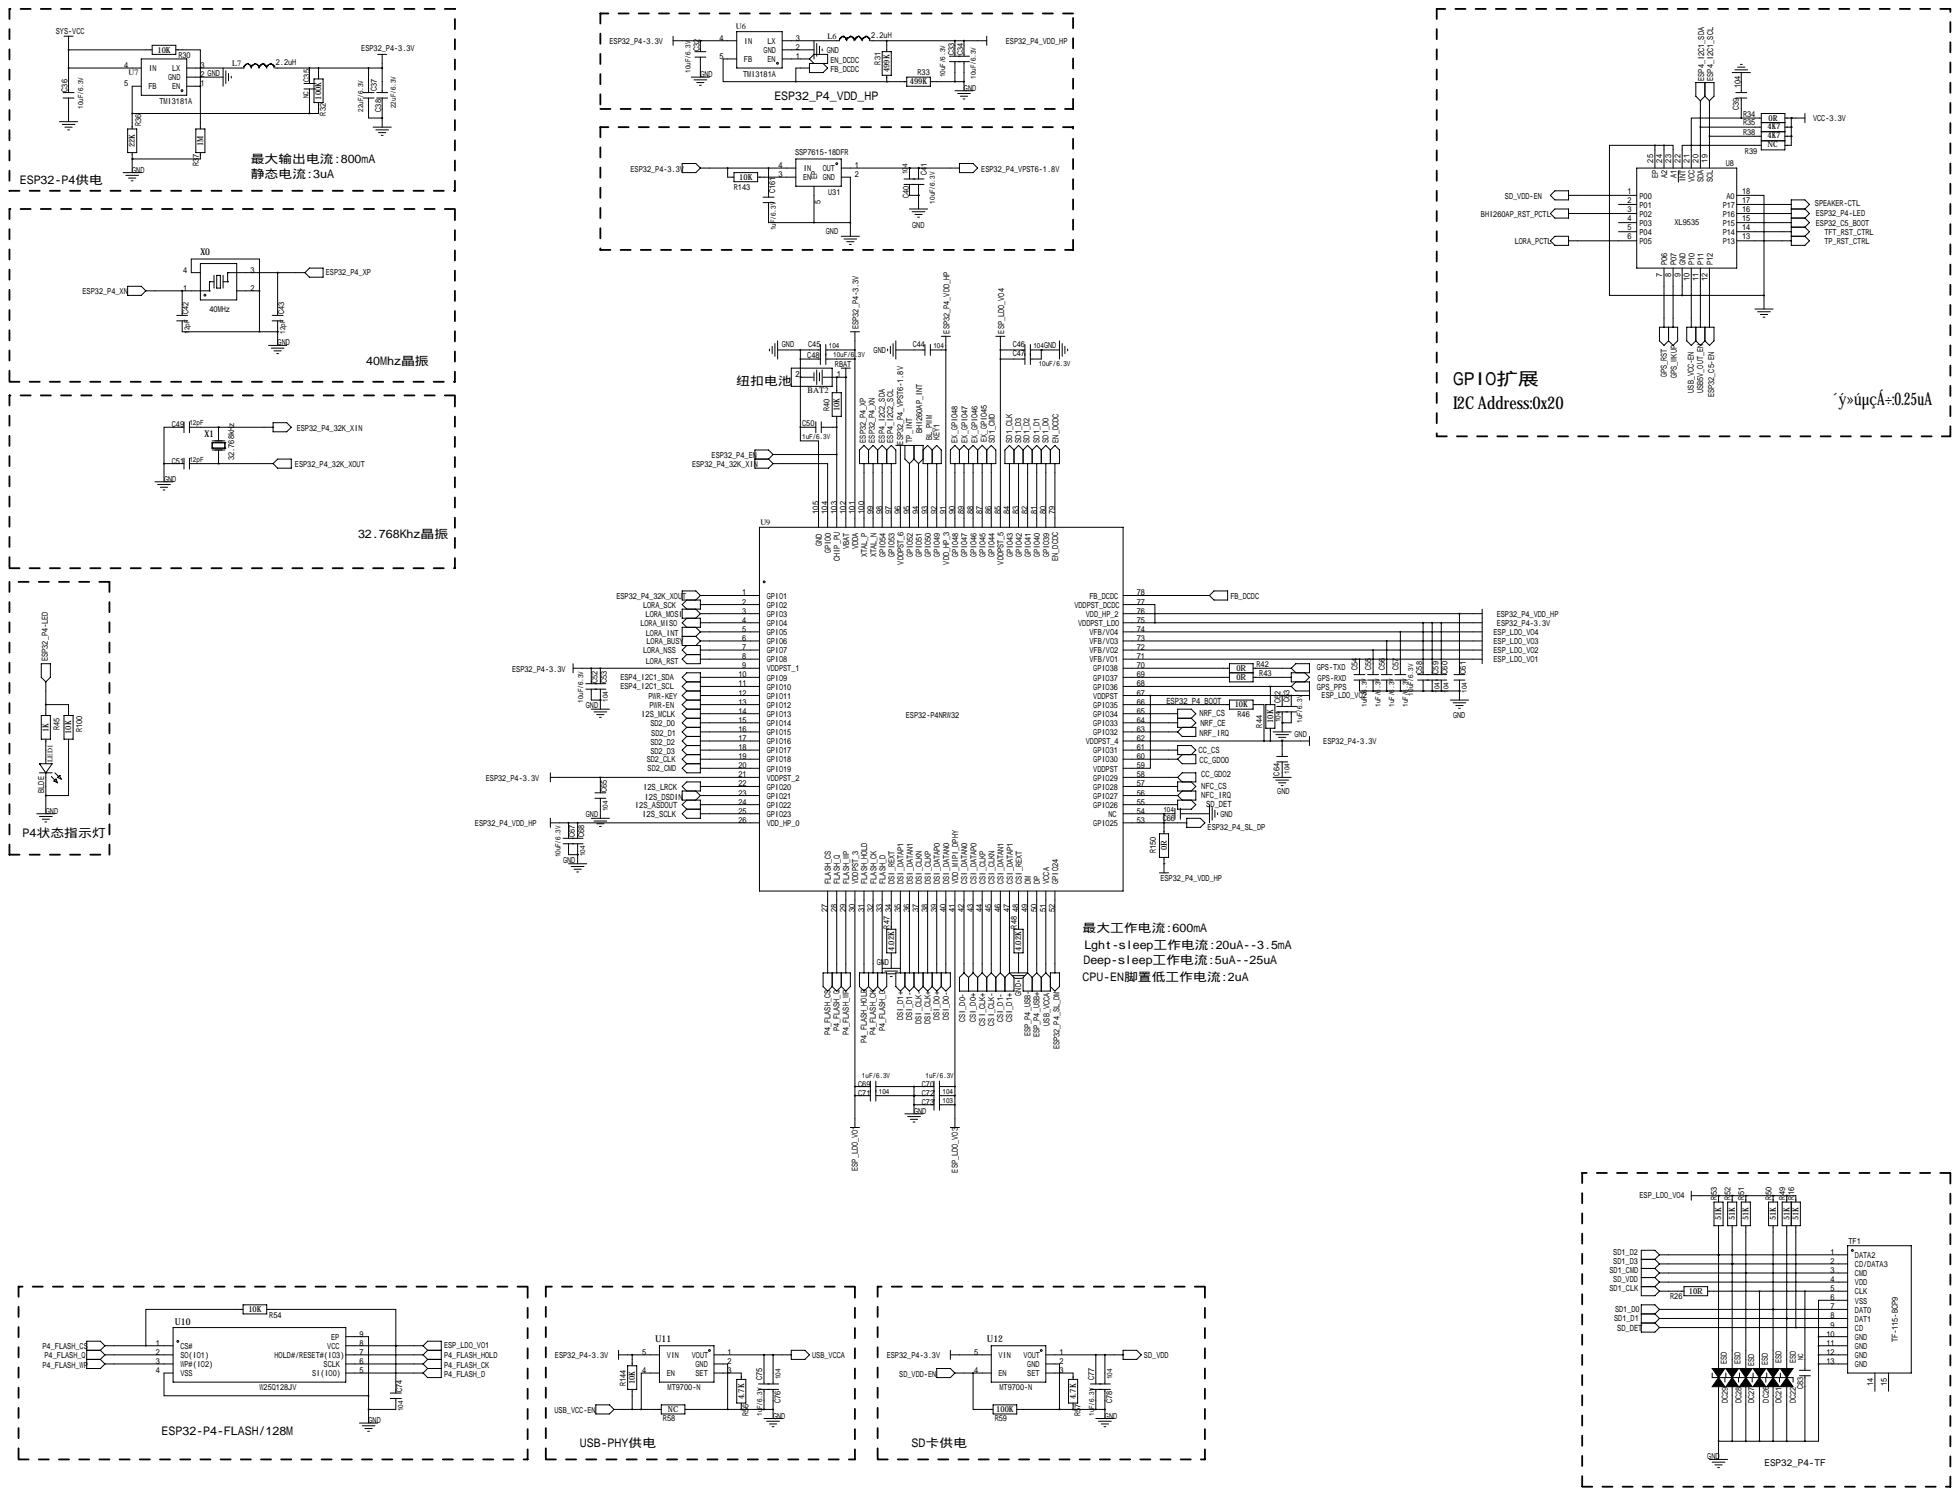
[picture p47: page 3]

## 40Mhz晶振

X2

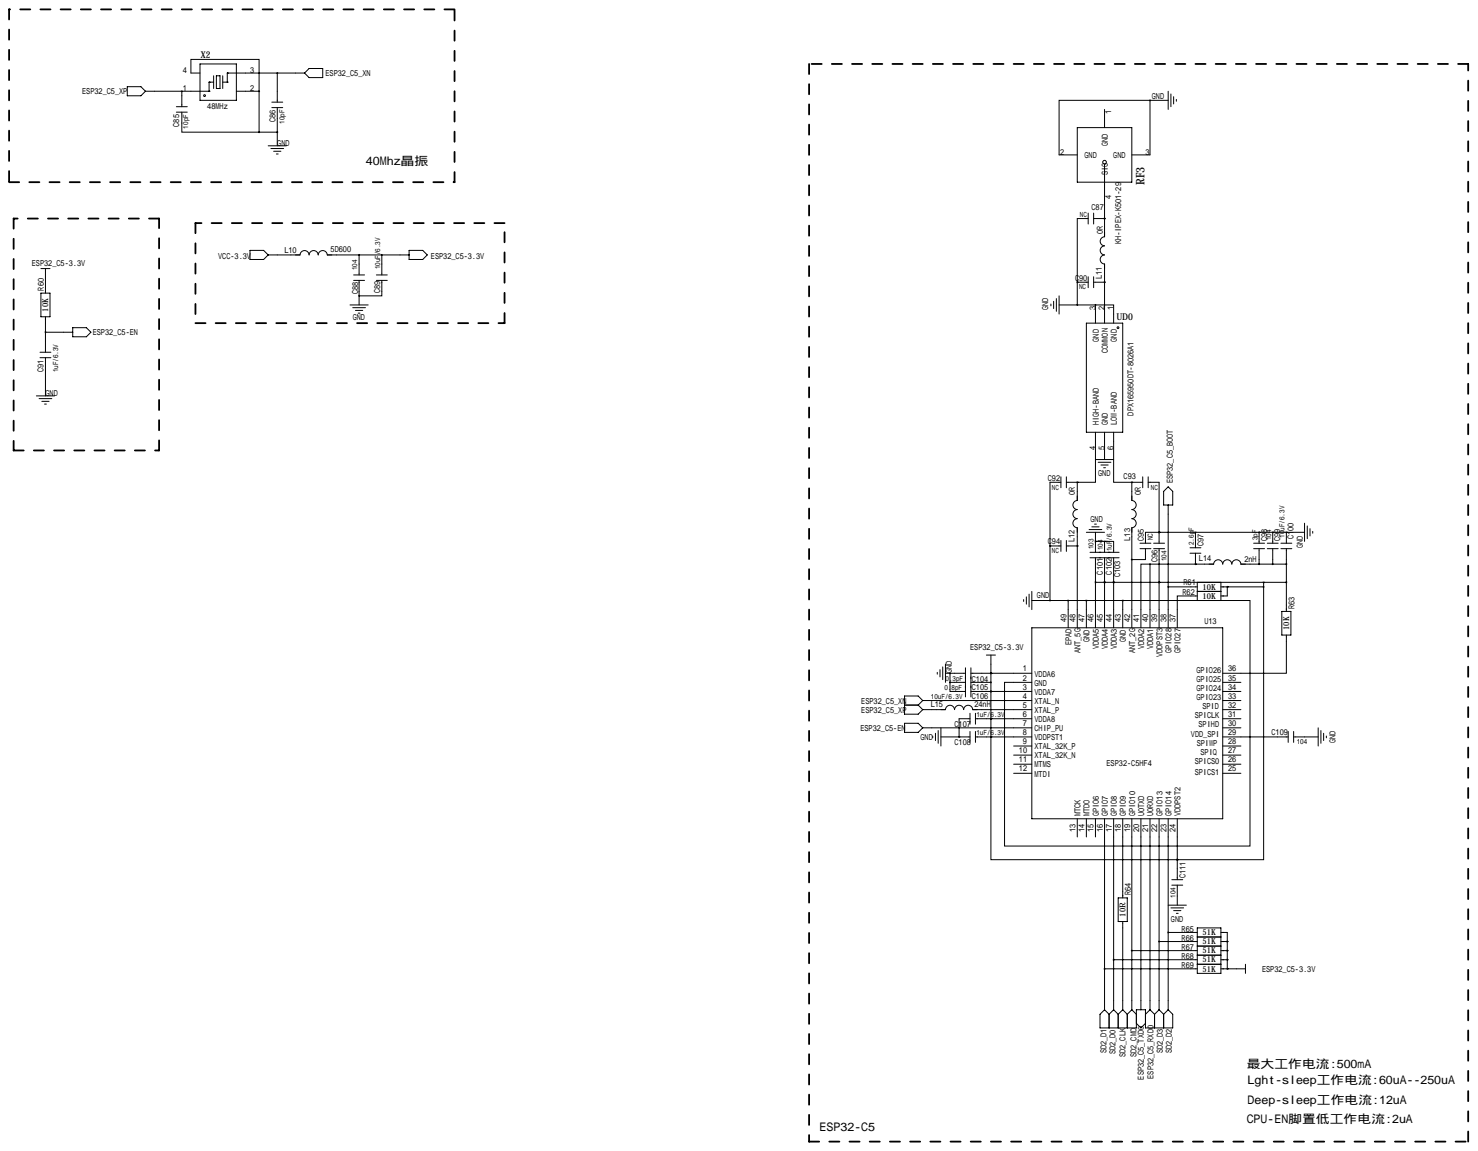
[picture p48: page 4]

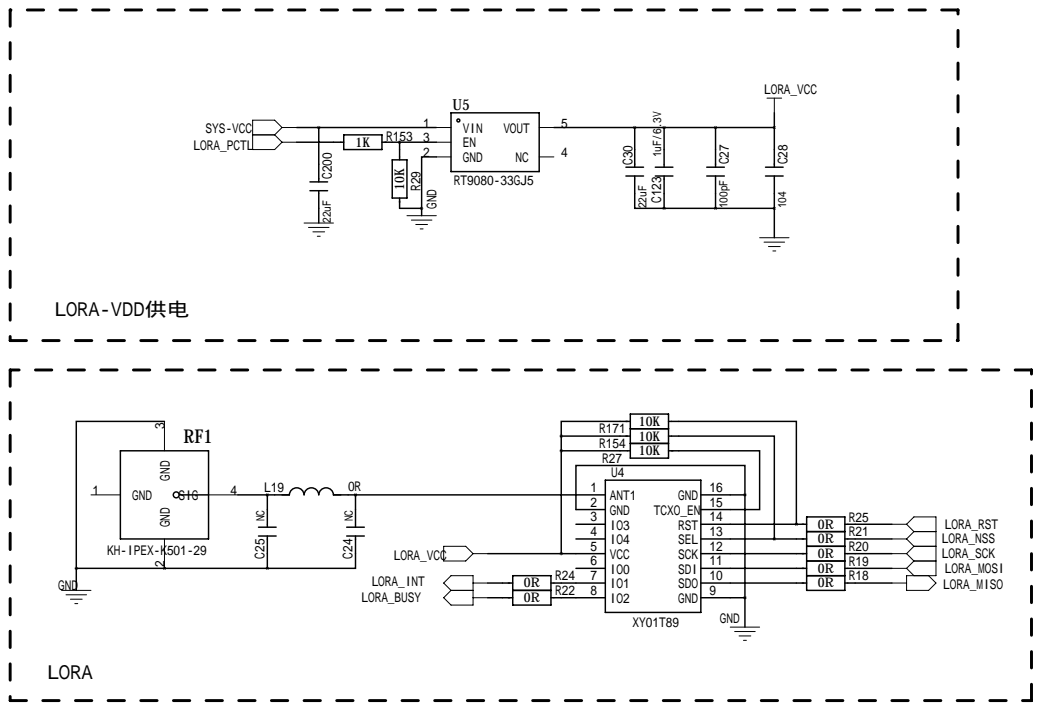
[picture p49: page 5]

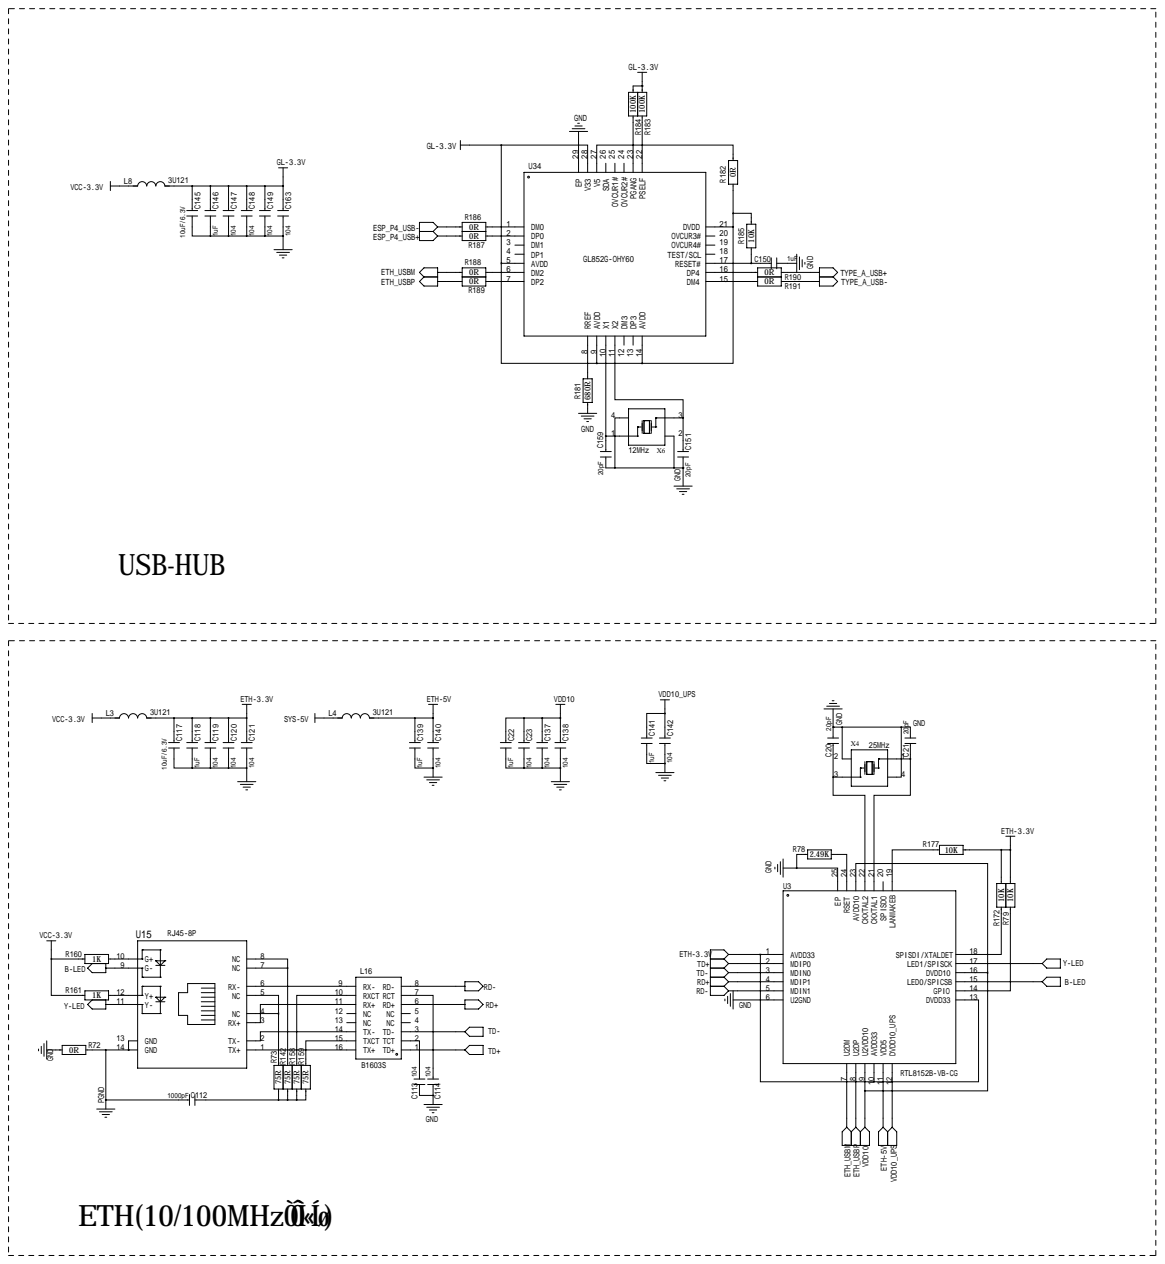
[picture p50: page 6]

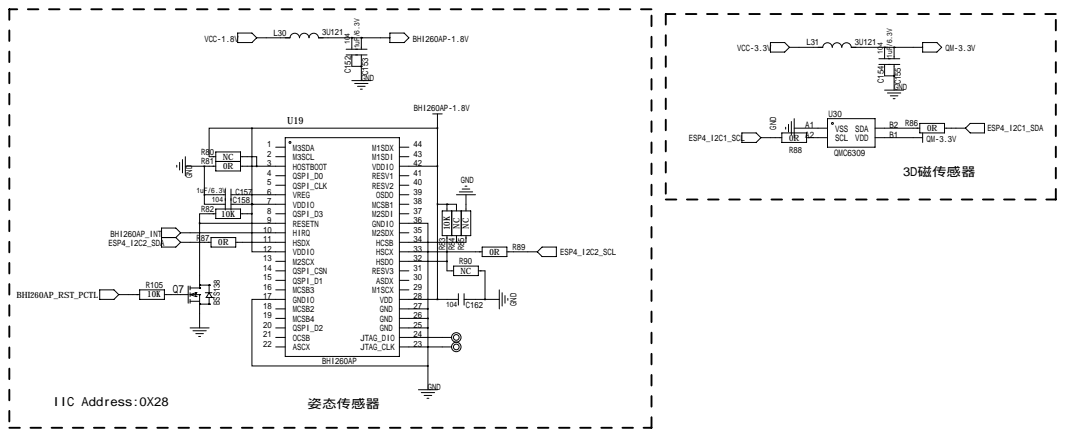
[picture p51: page 7]

10 | | 35 34
11
12 | | 33

32 | | R90
31 30 29 28

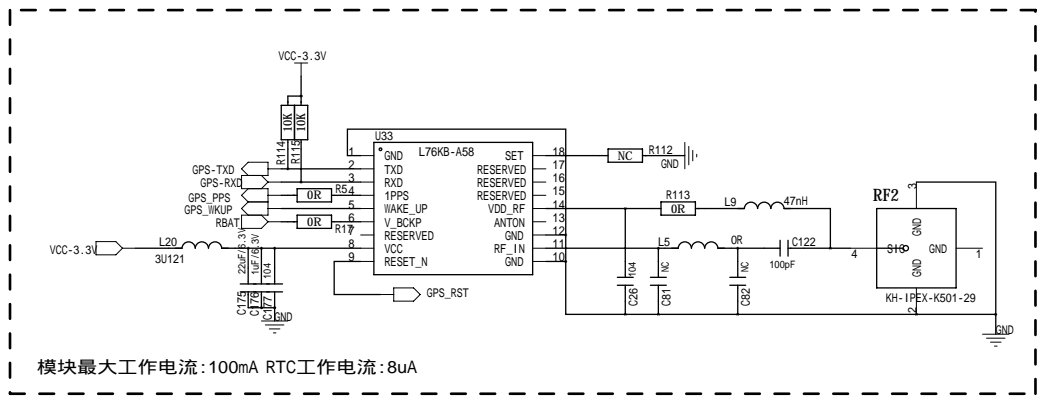
[picture p52: page 8]

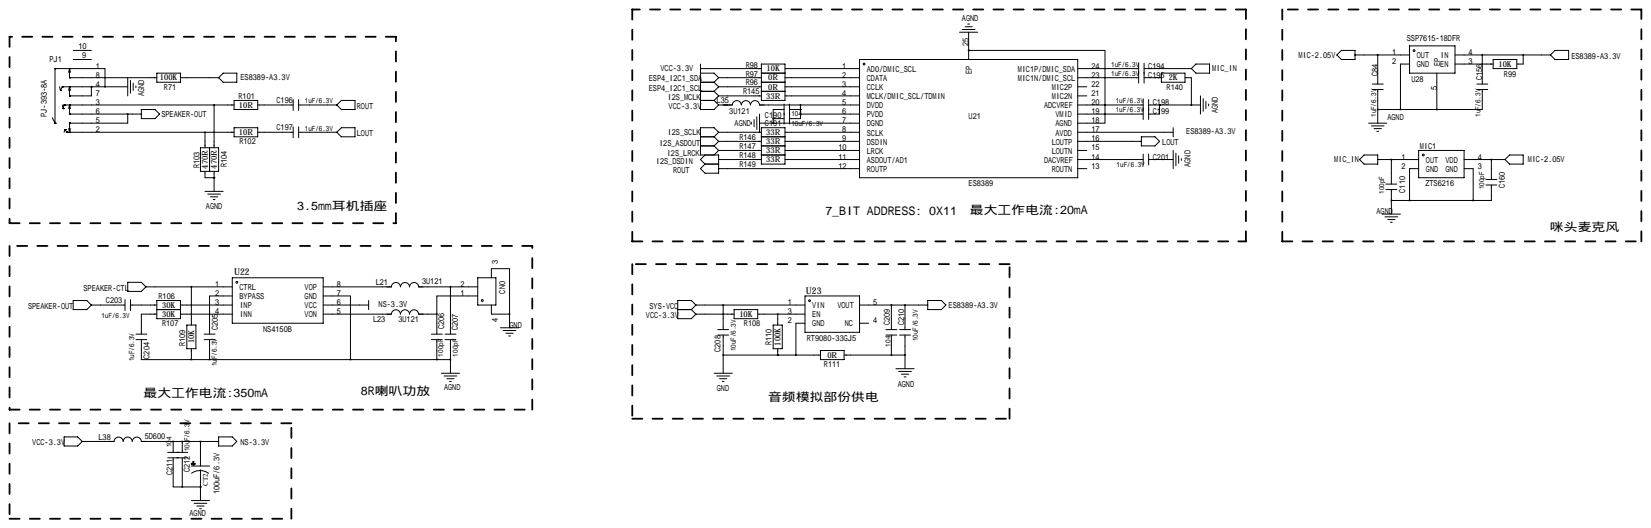
[picture p53: page 9]

19
18

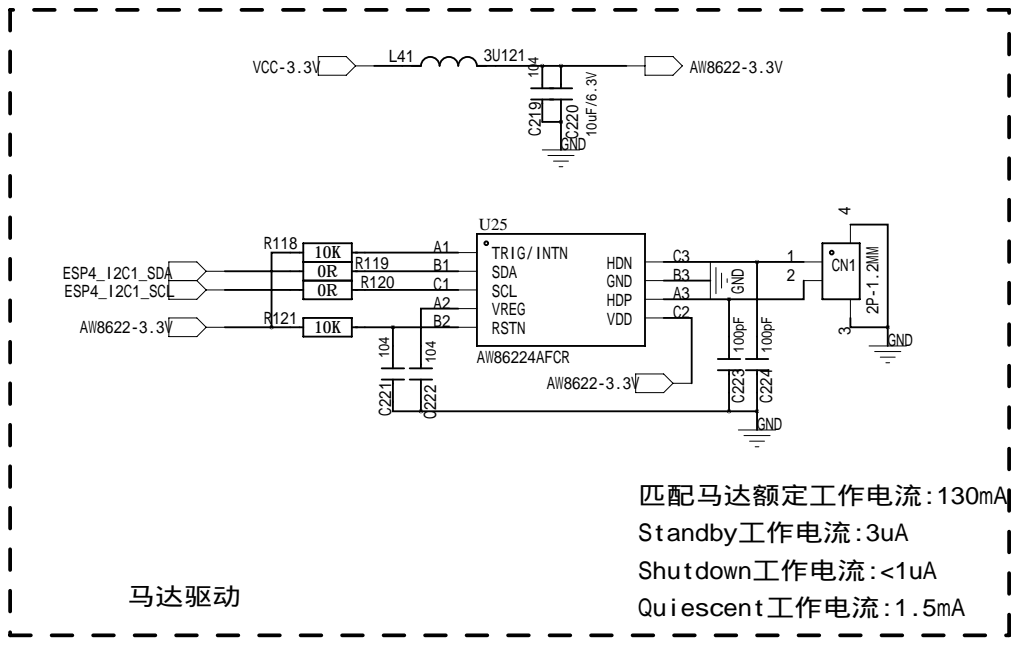
[picture p54: page 10]

## 动态工作电流:120mA--220mA

# R122 NC 5¹K

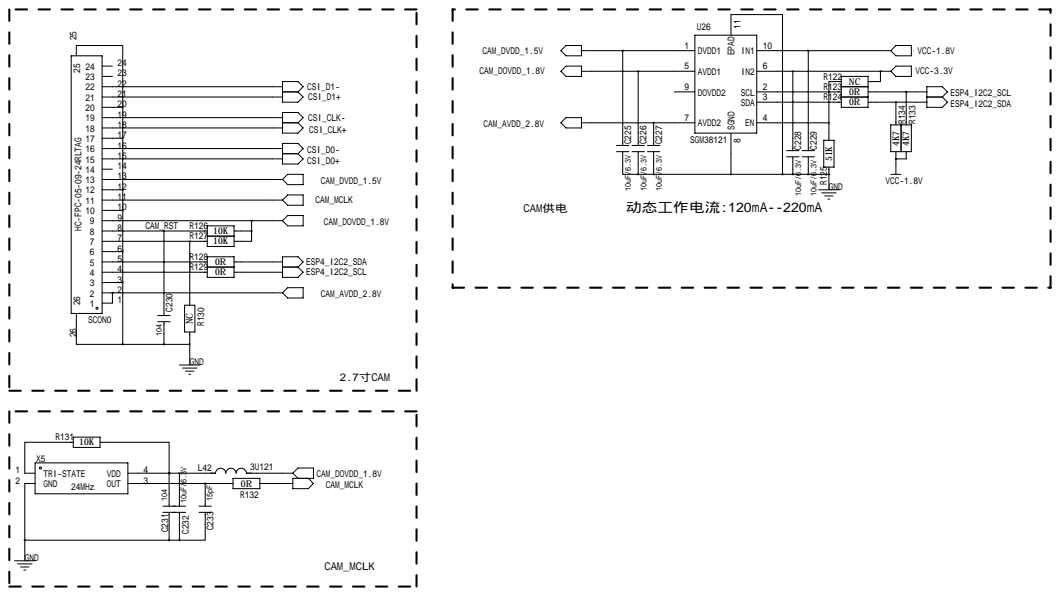
[picture p55: page 11]

CN2

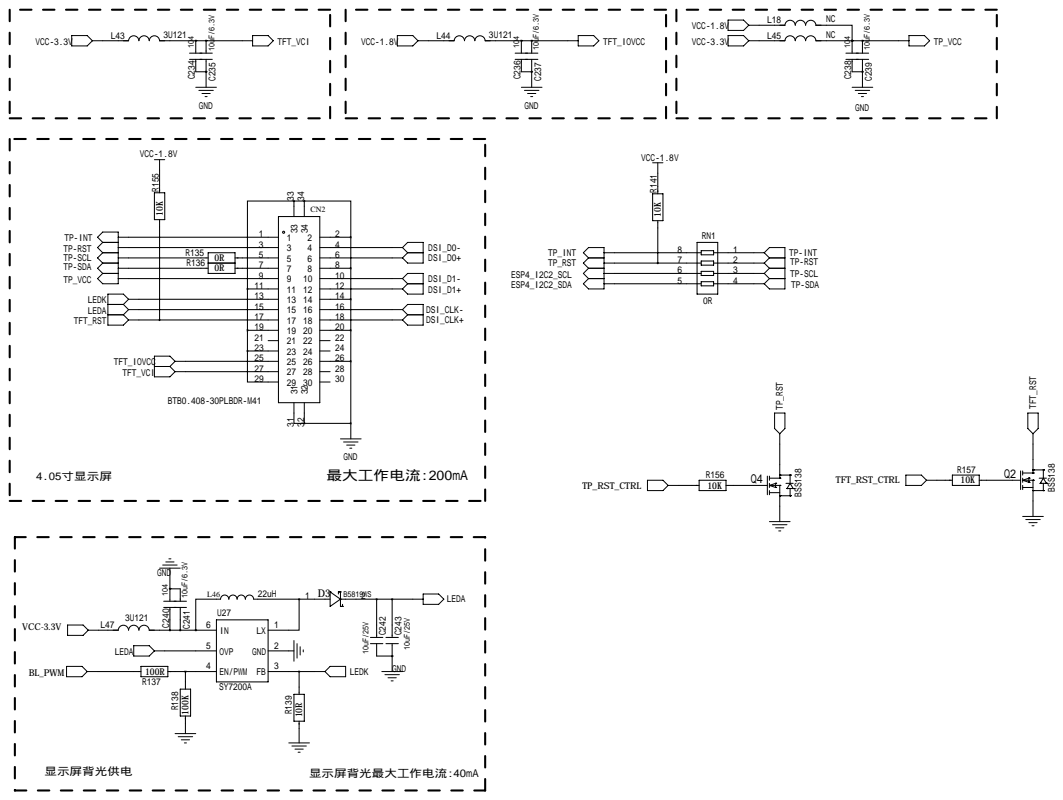
[picture p56: page 12]

13 | | 14
15 | | 16
17 | | 18
19 | | 20
21 23 | | 22 24 26
