Xinyuan-LilyGO/T-Display-P4/project/LR2021_868_915_V1.0.pdf

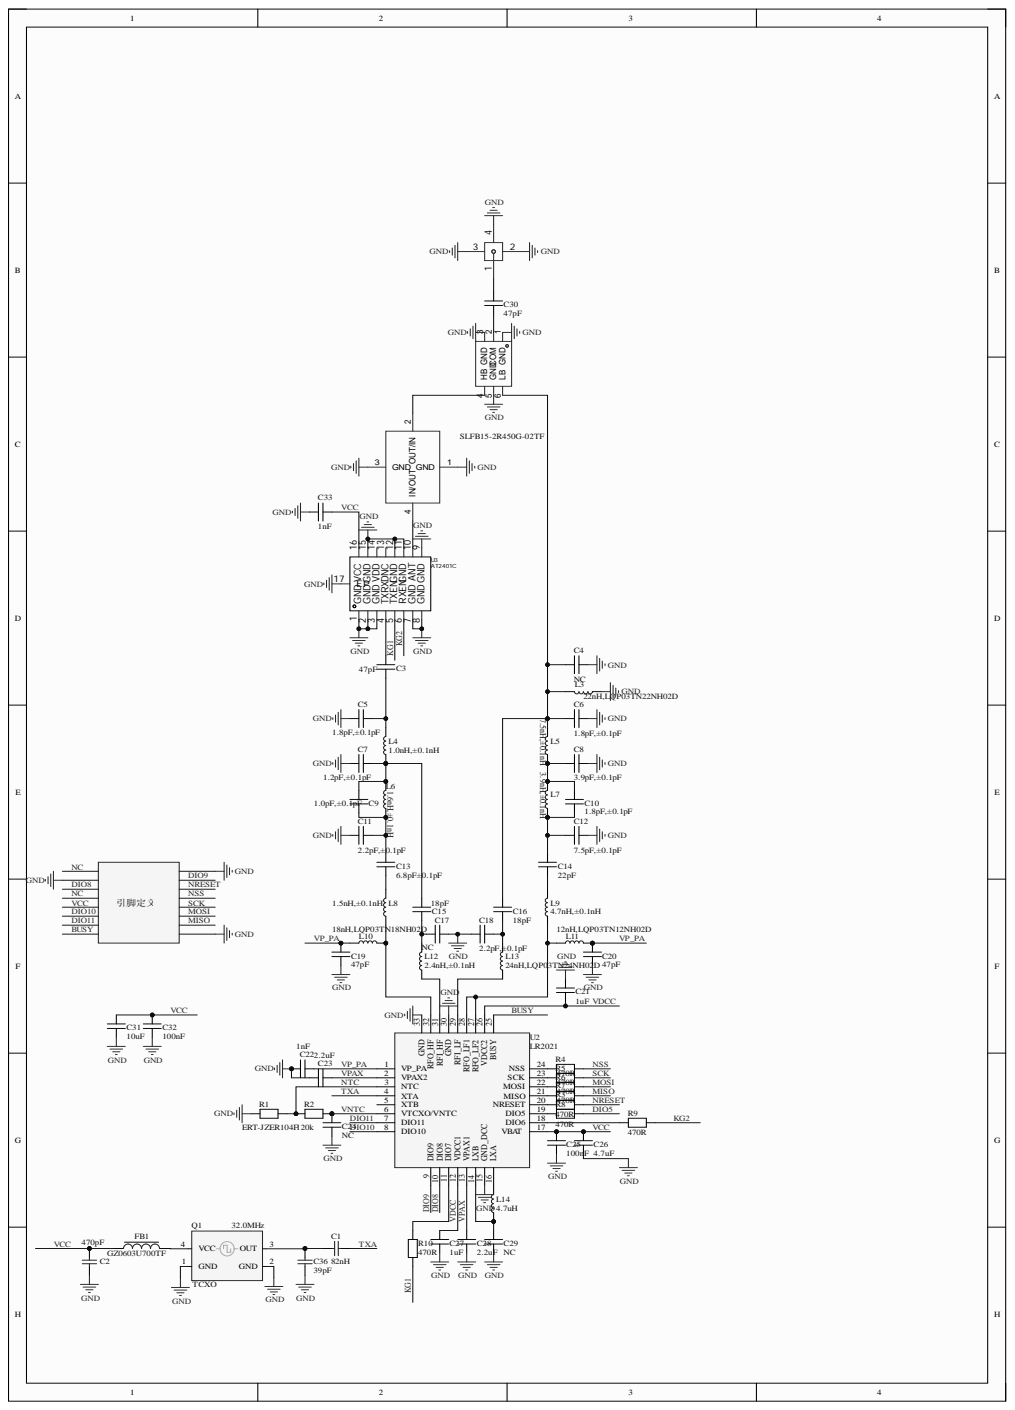
[picture p57: page 1]

GND 1 COM 2 GND 3 HB 4

GND 8 GND 9 ANT 10 GND 11 GND 12 DNC 13 VDD 14 GND 15 VCC 16 EP 17

TXA R2 | XTA 4 | MISO

VTCXO/VNTC 6 | DIO5
