Xinyuan-LilyGO/T-Display-P4/project/T-Display-P4-Keyboard_V1.1.pdf

# 矩阵按键

# I2C Address:0x34

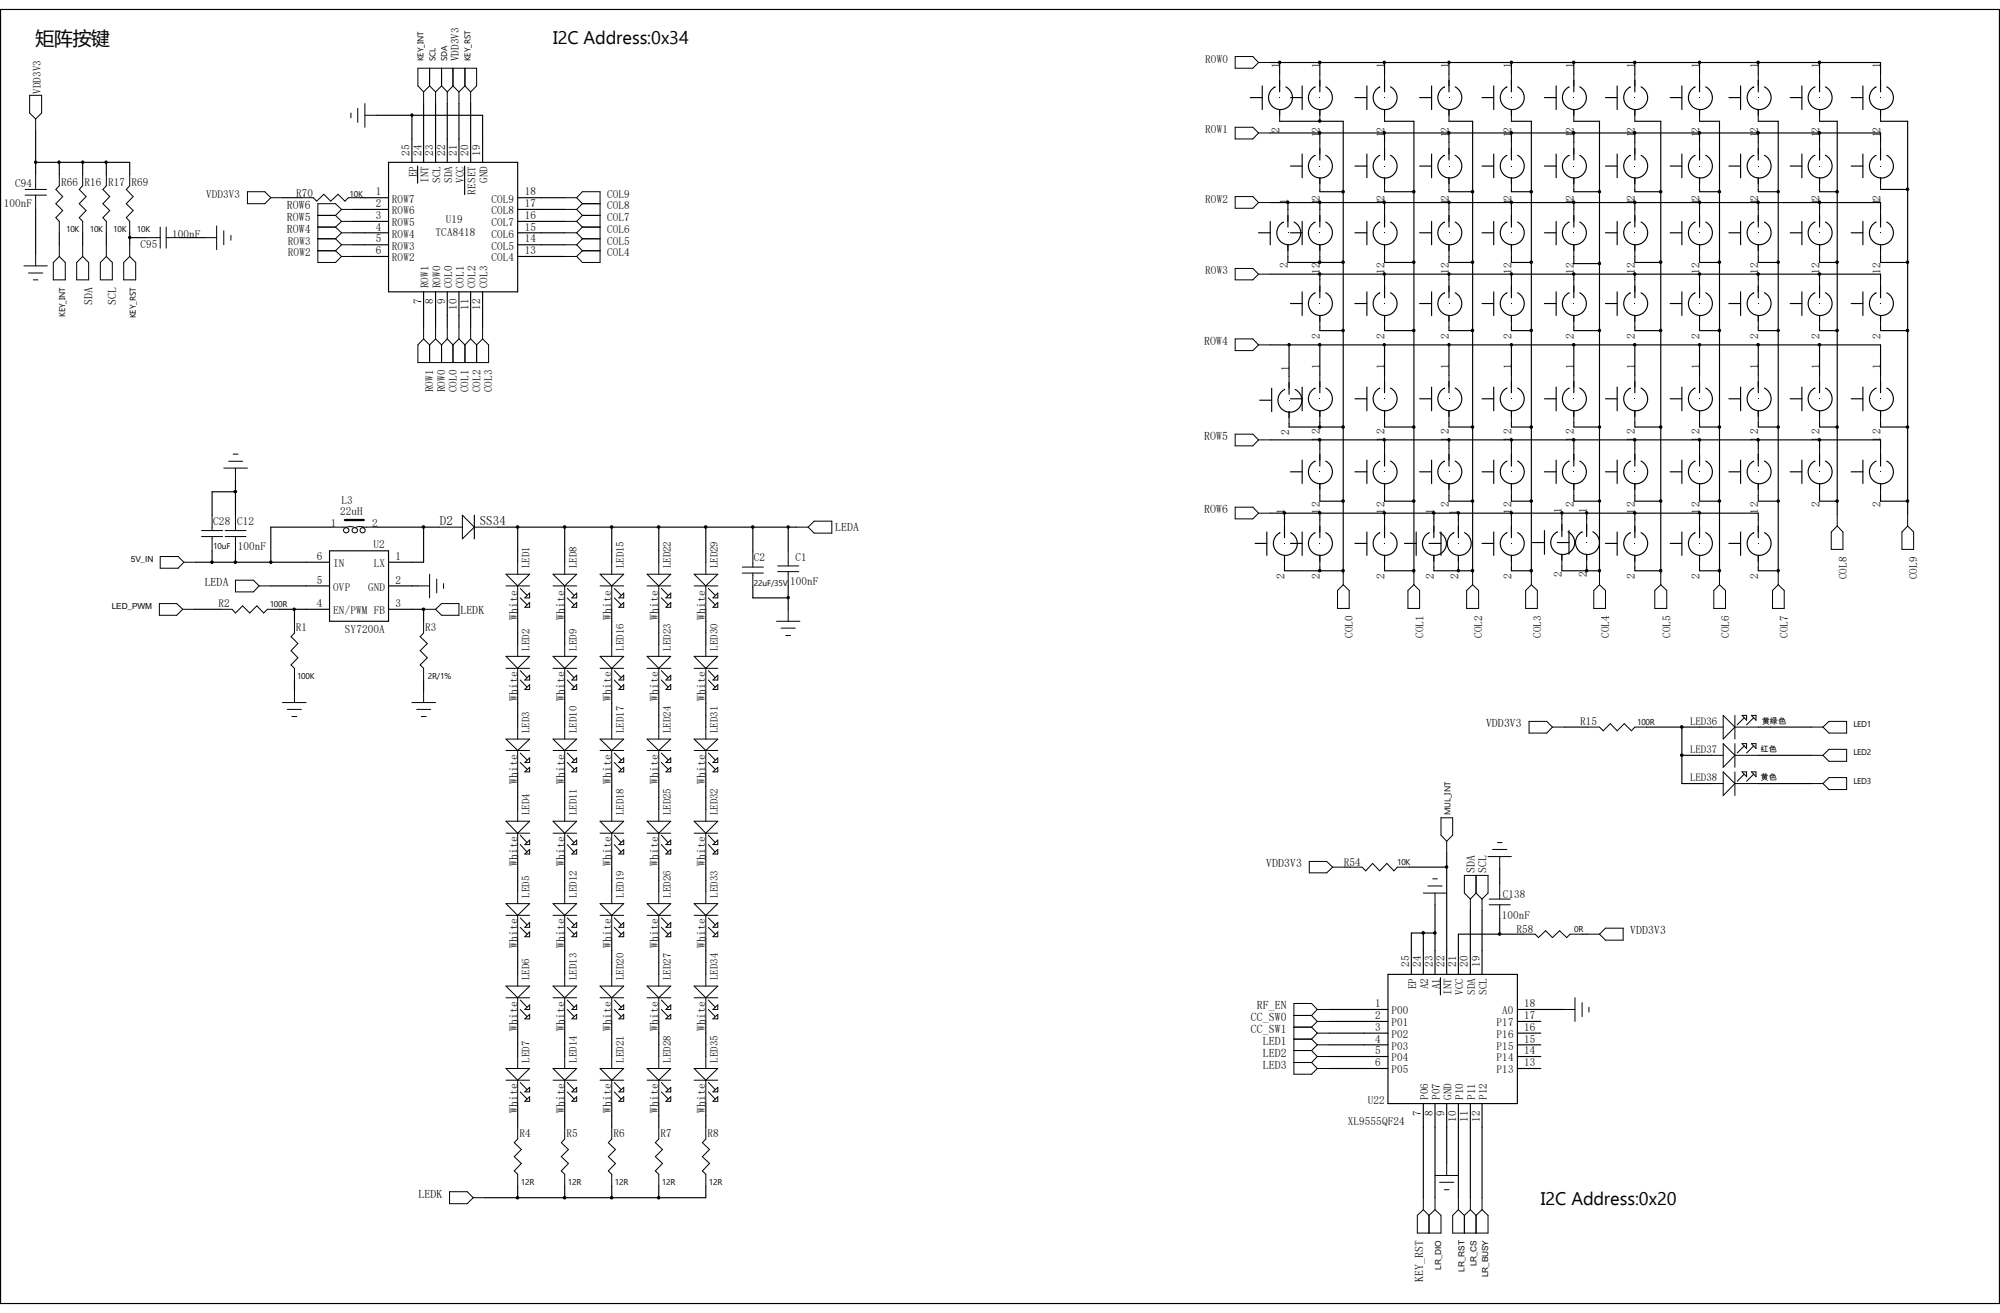
[picture p58: page 1]

18 COL9 ¹⁹ GND 20 RESET 21 VCC 22 SDA 23 SCL 24 INT 25 EP

18 A0 ¹⁹ SCL 20 SDA 21 VCC 22 INT 23 A1 24 A2 25 EP

| REVISION RECORD
LTR | ECO NO: | APPROVED: | DATE:

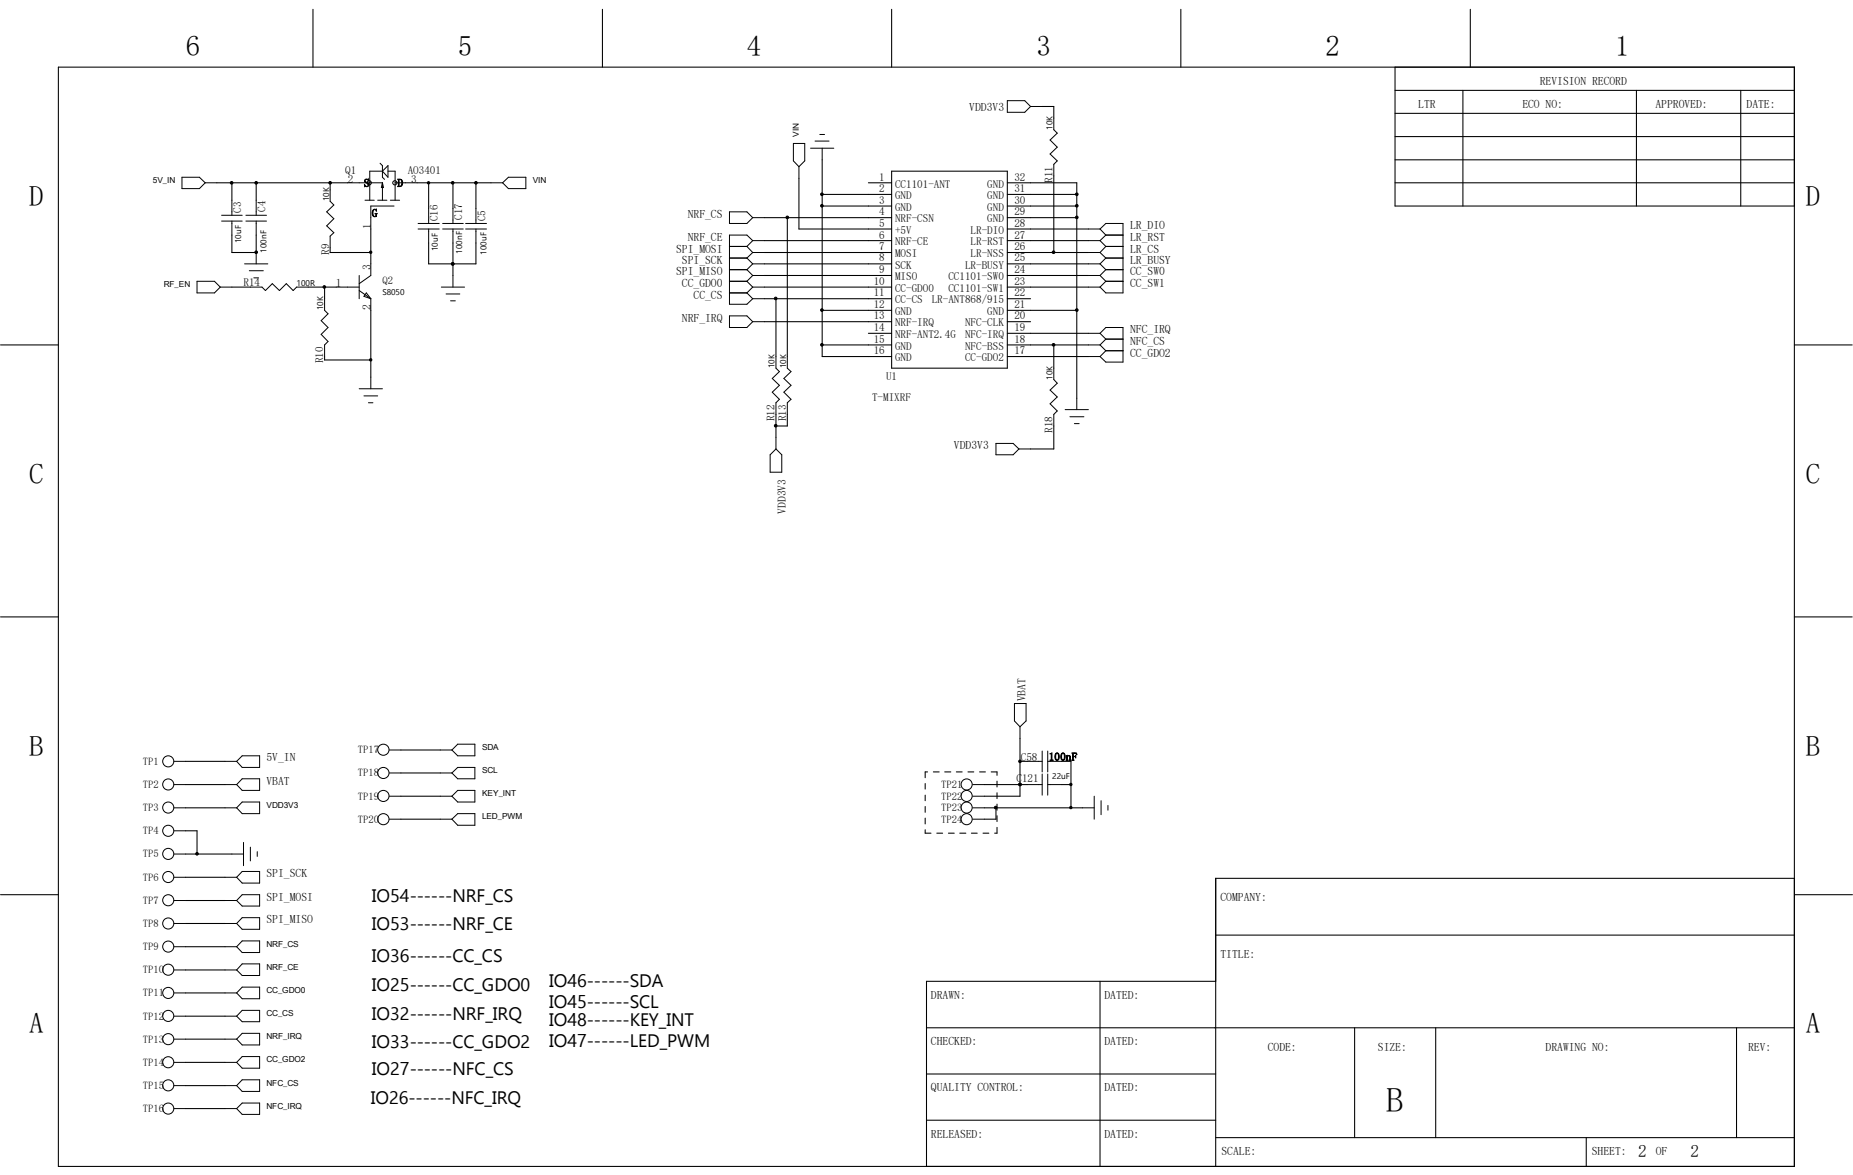
[picture p59: page 2]

31 GND
30 GND

GND 4 NRF-CSN 5 +5V 6 | 29 GND

28 LR-DIO

DRAWN: | DATED:
CHECKED: | DATED: | CODE: | SIZE: B | DRAWING NO: | REV:

QUALITY CONTROL: | DATED:

RELEASED: | DATED:

SCALE: | 2 2 SHEET: OF
