Xinyuan-LilyGO/T-Display-P4/project/LR2021_433_V0.3.pdf

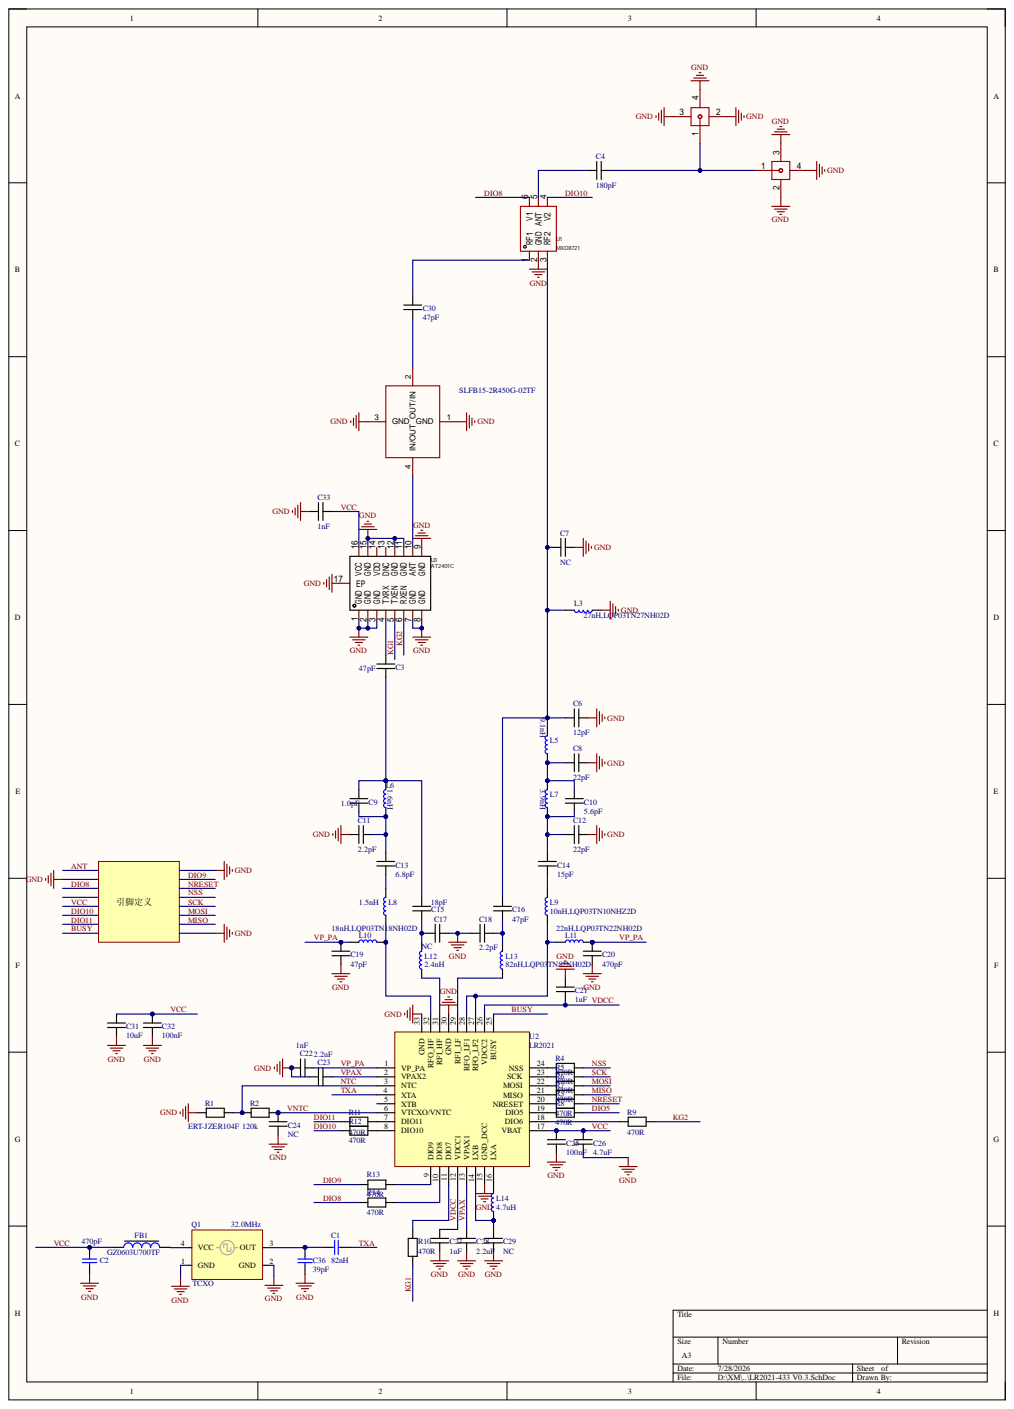
[picture p60: page 1]

Size A3 | Number | Revision

Date: 7/28/2026 | Sheet of
File: D:\XM\..\LR2021-433 V0.3.SchDoc | Drawn By:
