Xinyuan-LilyGO/T-Display-P4/components/private_library/ndef_custom_config.h

/**
  ******************************************************************************
  * @file           : ndef_custom_config.h
  * @brief          : This file contains definitions for st25r3916 Custom Configuration
  ******************************************************************************
  * @attention
  *
  * Copyright (c) 2024 STMicroelectronics.
  * All rights reserved.
  *
  * This software is licensed under terms that can be found in the LICENSE file
  * in the root directory of this software component.
  * If no LICENSE file comes with this software, it is provided AS-IS.
  *
  ******************************************************************************
  */

/* Define to prevent recursive inclusion -------------------------------------*/
#ifndef __NDEF_CUSTOM_CONFIG_H__
#define __NDEF_CUSTOM_CONFIG_H__


/*
 ******************************************************************************
 * INCLUDES
 ******************************************************************************
 */

#include <stdint.h>
#include <stdbool.h>
#include <st_errno.h>


/*
 ******************************************************************************
 * GLOBAL DEFINES
 ******************************************************************************
 */

/*
 ******************************************************************************
 * NDEF FEATURES CONFIGURATION
 ******************************************************************************
 */

#include "rfal_nfc.h"
#include "rfal_t4t.h"

#define ndefDevice                rfalNfcDevice           /*!< NDEF Device         */
#define NDEF_FEATURE_T1T          RFAL_FEATURE_T1T        /*!< T1T Support control */
#define NDEF_FEATURE_T2T          RFAL_FEATURE_T2T        /*!< T2T Support control */
#define NDEF_FEATURE_T3T          RFAL_FEATURE_NFCF       /*!< T3T Support control */
#define NDEF_FEATURE_T4T          RFAL_FEATURE_T4T        /*!< T4T Support control */
#define NDEF_FEATURE_T5T          RFAL_FEATURE_NFCV       /*!< T5T Support control */


#define NDEF_FEATURE_FULL_API                  true       /*!< Support Write, Format, Check Presence, set Read-only in addition to the Read feature */

#define NDEF_TYPE_EMPTY_SUPPORT                true       /*!< Support Empty type                          */
#define NDEF_TYPE_FLAT_SUPPORT                 true       /*!< Support Flat type                           */
#define NDEF_TYPE_RTD_DEVICE_INFO_SUPPORT      true       /*!< Support RTD Device Information type         */
#define NDEF_TYPE_RTD_TEXT_SUPPORT             true       /*!< Support RTD Text type                       */
#define NDEF_TYPE_RTD_URI_SUPPORT              true       /*!< Support RTD URI type                        */
#define NDEF_TYPE_RTD_AAR_SUPPORT              true       /*!< Support RTD Android Application Record type */
#define NDEF_TYPE_RTD_WLC_SUPPORT              true       /*!< Support RTD WLC Types                       */
#define NDEF_TYPE_RTD_WPCWLC_SUPPORT           true       /*!< Support RTD WPC WLC type                    */
#define NDEF_TYPE_RTD_TNEP_SUPPORT             true       /*!< Support RTD TNEP Types                      */
#define NDEF_TYPE_MEDIA_SUPPORT                true       /*!< Support Media type                          */
#define NDEF_TYPE_BLUETOOTH_SUPPORT            true       /*!< Support Bluetooth types                     */
#define NDEF_TYPE_VCARD_SUPPORT                true       /*!< Support vCard type                          */
#define NDEF_TYPE_WIFI_SUPPORT                 true       /*!< Support Wifi type                           */




#endif /* __NDEF_CUSTOM_CONFIG_H__*/
