Xinyuan-LilyGO/T-Display-P4/main/examples/hi8561_lvgl_touch_draw/main.cpp

/*
 * @Description: hi8561_lvgl_touch_draw
 * @Author: LILYGO_L
 * @Date: 2025-06-13 11:35:38
 * @LastEditTime: 2025-06-13 12:00:41
 * @License: GPL 3.0
 */
#include <stdio.h>
#include <unistd.h>
#include <sys/lock.h>
#include "sdkconfig.h"
#include "freertos/FreeRTOS.h"
#include "freertos/task.h"
#include "freertos/semphr.h"
#include "esp_timer.h"
#include "esp_lcd_panel_ops.h"
#include "esp_lcd_mipi_dsi.h"
#include "esp_ldo_regulator.h"
#include "driver/gpio.h"
#include "esp_err.h"
#include "esp_log.h"
#include "lvgl.h"
#include "hi8561_driver.h"
#include "t_display_p4_config.h"
#include "cpp_bus_driver_library.h"

#define LVGL_TICK_PERIOD_MS 2

static const char *TAG = "example";

size_t Cycle_Time = 0;

esp_lcd_panel_handle_t screen_mipi_dpi_panel = NULL;

std::vector<uint16_t> Lvgl_Draw_X_Data;
std::vector<uint16_t> Lvgl_Draw_Y_Data;

// LVGL library is not thread-safe, this example will call LVGL APIs from different tasks, so use a mutex to protect it
static _lock_t lvgl_api_lock;

// 定义一个计时器，用于检测 5 秒无操作
time_t last_touch_time = 0;

// 定义一个标志，用于判断是否需要清除画布
bool need_clear_lock_flag = false;

// 定义一个画布对象
static lv_obj_t *canvas;
static lv_layer_t layer;

lv_point_t point;

auto XL9535_Bus = std::make_shared<Cpp_Bus_Driver::Hardware_Iic_1>(XL9535_SDA, XL9535_SCL, I2C_NUM_0);
auto HI8561_T_Bus = std::make_shared<Cpp_Bus_Driver::Hardware_Iic_1>(HI8561_TOUCH_SDA, HI8561_TOUCH_SCL, I2C_NUM_0);

auto XL9535 = std::make_unique<Cpp_Bus_Driver::Xl95x5>(XL9535_Bus, XL9535_IIC_ADDRESS, DEFAULT_CPP_BUS_DRIVER_VALUE);

auto HI8561_T = std::make_unique<Cpp_Bus_Driver::Hi8561_Touch>(HI8561_T_Bus, HI8561_TOUCH_ADDRESS, DEFAULT_CPP_BUS_DRIVER_VALUE);

auto ESP32P4 = std::make_unique<Cpp_Bus_Driver::Tool>();

void example_lvgl_flush_cb(lv_display_t *disp, const lv_area_t *area, uint8_t *px_map)
{
    esp_lcd_panel_handle_t panel_handle = (esp_lcd_panel_handle_t)lv_display_get_user_data(disp);
    int offsetx1 = area->x1;
    int offsetx2 = area->x2;
    int offsety1 = area->y1;
    int offsety2 = area->y2;
    // pass the draw buffer to the driver
    esp_lcd_panel_draw_bitmap(panel_handle, offsetx1, offsety1, offsetx2 + 1, offsety2 + 1, px_map);
}

void example_increase_lvgl_tick(void *arg)
{
    /* Tell LVGL how many milliseconds has elapsed */
    lv_tick_inc(LVGL_TICK_PERIOD_MS);
}

void example_lvgl_port_task(void *arg)
{
    ESP_LOGI(TAG, "Starting LVGL task");
    while (1)
    {
        // _lock_acquire(&lvgl_api_lock);
        // time_till_next_ms = lv_timer_handler();
        // _lock_release(&lvgl_api_lock);

        // 获取当前时间
        time_t current_time = time(NULL);

        // 如果距离上次触摸时间超过 5 秒，则清除画布
        if ((current_time - last_touch_time > 5) && (need_clear_lock_flag == true))
        {
            lv_canvas_fill_bg(canvas, lv_color_hex3(0xccc), LV_OPA_COVER);
            last_touch_time = current_time;

            Lvgl_Draw_X_Data.clear();
            Lvgl_Draw_Y_Data.clear();

            need_clear_lock_flag = false;
        }

        lv_timer_handler();

        vTaskDelay(pdMS_TO_TICKS(10));
    }
}

bool example_notify_lvgl_flush_ready(esp_lcd_panel_handle_t panel, esp_lcd_dpi_panel_event_data_t *edata, void *user_ctx)
{
    lv_display_t *disp = (lv_display_t *)user_ctx;
    lv_display_flush_ready(disp);
    return false;
}

bool example_monitor_refresh_rate(esp_lcd_panel_handle_t panel, esp_lcd_dpi_panel_event_data_t *edata, void *user_ctx)
{
    // static int io_level = 0;
    // // please note, the real refresh rate should be 2*frequency of this GPIO toggling
    // gpio_set_level(EXAMPLE_PIN_NUM_REFRESH_MONITOR, io_level);
    // io_level = !io_level;
    return false;
}

void example_bsp_enable_dsi_phy_power(void)
{
    // Turn on the power for MIPI DSI PHY, so it can go from "No Power" state to "Shutdown" state
    esp_ldo_channel_handle_t ldo_mipi_phy = NULL;
    esp_ldo_channel_config_t ldo_mipi_phy_config = {
        .chan_id = 3,
        .voltage_mv = 2500,
    };
    ESP_ERROR_CHECK(esp_ldo_acquire_channel(&ldo_mipi_phy_config, &ldo_mipi_phy));
    printf("mipi dsi phy powered on\n");
}

void example_bsp_init_refresh_monitor_io(void)
{
    // gpio_config_t monitor_io_conf = {
    //     .pin_bit_mask = 1ULL << EXAMPLE_PIN_NUM_REFRESH_MONITOR,
    //     .mode = GPIO_MODE_OUTPUT,
    // };
    // ESP_ERROR_CHECK(gpio_config(&monitor_io_conf));
}

void my_touchpad_read(lv_indev_t *indev, lv_indev_data_t *data)
{
    // if (XL9535->pin_read(XL9535_TOUCH_INT) == 0)
    // {
    Cpp_Bus_Driver::Hi8561_Touch::Touch_Point tp;

    if (HI8561_T->get_single_touch_point(tp) == true)
    {
        // printf("touch finger: %d edge touch flag: %d\nx: %d y: %d p: %d\n", tp.finger_count, tp.edge_touch_flag, tp.num_info[0].x, tp.num_info[0].y, tp.num_info[0].p);
        data->state = LV_INDEV_STATE_PR;

        /*Set the coordinates*/
        data->point.x = tp.info[0].x;
        data->point.y = tp.info[0].y;
    }
    else
    {
        data->state = LV_INDEV_STATE_REL;
    }
    // }
}

// 绘图回调函数
void draw_point(lv_event_t *e)
{
    // lv_obj_t *obj = lv_event_get_target(e);
    lv_event_code_t code = lv_event_get_code(e);

    // printf("code: %d\n", code);

    switch (code)
    {
    case LV_EVENT_PRESSING:
    {
        lv_indev_t *indev = lv_indev_get_act();
        lv_indev_get_point(indev, &point);

        // printf("touch x: %ld y: %ld\n", point.x, point.y);

        // 在画布上绘制点
        // lv_canvas_set_px(canvas, point.x, point.y, lv_palette_main(LV_PALETTE_RED), LV_OPA_COVER);

        Lvgl_Draw_X_Data.push_back(point.x);
        Lvgl_Draw_Y_Data.push_back(point.y);

        if ((Lvgl_Draw_X_Data.size() >= 2) && (Lvgl_Draw_Y_Data.size() >= 2))
        {
            lv_draw_line_dsc_t dsc;
            lv_draw_line_dsc_init(&dsc);
            dsc.color = lv_palette_main(LV_PALETTE_RED);
            dsc.width = 4;
            dsc.round_end = 1;
            dsc.round_start = 1;
            dsc.p1.x = Lvgl_Draw_X_Data[0];
            dsc.p1.y = Lvgl_Draw_Y_Data[0];
            dsc.p2.x = Lvgl_Draw_X_Data[1];
            dsc.p2.y = Lvgl_Draw_Y_Data[1];
            lv_draw_line(&layer, &dsc);

            lv_canvas_finish_layer(canvas, &layer);

            Lvgl_Draw_X_Data.erase(Lvgl_Draw_X_Data.begin());
            Lvgl_Draw_Y_Data.erase(Lvgl_Draw_Y_Data.begin());
        }

        // 获取当前时间
        time_t current_time = time(NULL);
        // 更新上次触摸时间
        last_touch_time = current_time;
        need_clear_lock_flag = true;
    }
    break;
    case LV_EVENT_RELEASED:
        //  printf("777\n");
        Lvgl_Draw_X_Data.clear();
        Lvgl_Draw_Y_Data.clear();
        break;

    default:
        break;
    }
}

void lv_example_canvas_7(void)
{
    void *draw_buf = NULL;
    size_t draw_buffer_sz = HI8561_SCREEN_WIDTH * HI8561_SCREEN_HEIGHT * sizeof(lv_color_t);
    draw_buf = heap_caps_malloc(draw_buffer_sz, MALLOC_CAP_SPIRAM);

    /*Create a canvas and initialize its palette*/
    canvas = lv_canvas_create(lv_screen_active());
    // lv_canvas_set_draw_buf(canvas, (lv_draw_buf_t *)draw_buf);
    lv_canvas_set_buffer(canvas, draw_buf, HI8561_SCREEN_WIDTH, HI8561_SCREEN_HEIGHT, LV_COLOR_FORMAT_RGB888);
    lv_canvas_fill_bg(canvas, lv_color_hex3(0xCCC), LV_OPA_COVER);
    lv_obj_center(canvas);

    lv_canvas_init_layer(canvas, &layer);

    lv_draw_line_dsc_t dsc;
    lv_draw_line_dsc_init(&dsc);
    dsc.color = lv_palette_main(LV_PALETTE_RED);
    dsc.width = 4;
    dsc.round_end = 1;
    dsc.round_start = 1;
    dsc.p1.x = 15;
    dsc.p1.y = 15;
    dsc.p2.x = 35;
    dsc.p2.y = 10;
    lv_draw_line(&layer, &dsc);

    lv_canvas_finish_layer(canvas, &layer);

    // 注册触摸事件回调
    lv_obj_add_event_cb(lv_screen_active(), draw_point, LV_EVENT_ALL, NULL);
}

bool Mipi_Dsi_Init(uint8_t num_data_lanes, uint32_t lane_bit_rate_mbps, uint32_t dpi_clock_freq_mhz, lcd_color_rgb_pixel_format_t color_rgb_pixel_format, uint8_t num_fbs, uint32_t width, uint32_t height,
                   uint32_t mipi_dsi_hsync, uint32_t mipi_dsi_hbp, uint32_t mipi_dsi_hfp, uint32_t mipi_dsi_vsync, uint32_t mipi_dsi_vbp, uint32_t mipi_dsi_vfp,
                   uint32_t bits_per_pixel, esp_lcd_panel_handle_t *mipi_dpi_panel)
{
    esp_lcd_dsi_bus_handle_t mipi_dsi_bus;
    esp_lcd_panel_io_handle_t mipi_dbi_io;

    auto cpp_assert = std::make_unique<Cpp_Bus_Driver::Tool>();

    // create MIPI DSI bus first, it will initialize the DSI PHY as well
    esp_lcd_dsi_bus_config_t bus_config = {
        .bus_id = 0,
        .num_data_lanes = num_data_lanes,
        .phy_clk_src = MIPI_DSI_PHY_CLK_SRC_DEFAULT,
        .lane_bit_rate_mbps = lane_bit_rate_mbps,
    };

    esp_err_t assert = esp_lcd_new_dsi_bus(&bus_config, &mipi_dsi_bus);
    if (assert != ESP_OK)
    {
        cpp_assert->assert_log(Cpp_Bus_Driver::Tool::Log_Level::INFO, __FILE__, __LINE__, "esp_lcd_new_dsi_bus fail (error code: %#X)\n", assert);
        return false;
    }

    // we use DBI interface to send LCD commands and parameters
    esp_lcd_dbi_io_config_t dbi_io_config = {
        .virtual_channel = 0,
        .lcd_cmd_bits = 8,   // according to the LCD spec
        .lcd_param_bits = 8, // according to the LCD spec
    };
    assert = esp_lcd_new_panel_io_dbi(mipi_dsi_bus, &dbi_io_config, &mipi_dbi_io);
    if (assert != ESP_OK)
    {
        cpp_assert->assert_log(Cpp_Bus_Driver::Tool::Log_Level::INFO, __FILE__, __LINE__, "esp_lcd_new_panel_io_dbi fail (error code: %#X)\n", assert);
        return false;
    }

    esp_lcd_dpi_panel_config_t dpi_config = {
        .virtual_channel = 0,
        .dpi_clk_src = MIPI_DSI_DPI_CLK_SRC_DEFAULT,
        .dpi_clock_freq_mhz = dpi_clock_freq_mhz,
        .pixel_format = color_rgb_pixel_format,
        .num_fbs = num_fbs,
        .video_timing = {
            .h_size = width,
            .v_size = height,
            .hsync_pulse_width = mipi_dsi_hsync,
            .hsync_back_porch = mipi_dsi_hbp,
            .hsync_front_porch = mipi_dsi_hfp,
            .vsync_pulse_width = mipi_dsi_vsync,
            .vsync_back_porch = mipi_dsi_vbp,
            .vsync_front_porch = mipi_dsi_vfp,
        },
        .flags = {
            .use_dma2d = true, // use DMA2D to copy draw buffer into frame buffer
        }};

    hi8561_vendor_config_t vendor_config = {
        .mipi_config = {
            .dsi_bus = mipi_dsi_bus,
            .dpi_config = &dpi_config,
        },
    };
    esp_lcd_panel_dev_config_t dev_config = {
        .reset_gpio_num = -1,
        .rgb_ele_order = LCD_RGB_ELEMENT_ORDER_RGB,
        .bits_per_pixel = bits_per_pixel,
        .vendor_config = &vendor_config,
    };
    assert = esp_lcd_new_panel_hi8561(mipi_dbi_io, &dev_config, mipi_dpi_panel);
    if (assert != ESP_OK)
    {
        cpp_assert->assert_log(Cpp_Bus_Driver::Tool::Log_Level::INFO, __FILE__, __LINE__, "esp_lcd_new_panel_hi8561 fail (error code: %#X)\n", assert);
        return false;
    }

    return true;
}

bool Screen_Init(esp_lcd_panel_handle_t *mipi_dpi_panel)
{
    if (Mipi_Dsi_Init(HI8561_SCREEN_DATA_LANE_NUM, HI8561_SCREEN_LANE_BIT_RATE_MBPS, HI8561_SCREEN_MIPI_DSI_DPI_CLK_MHZ, LCD_COLOR_PIXEL_FORMAT_RGB565,
                      0, HI8561_SCREEN_WIDTH, HI8561_SCREEN_HEIGHT, HI8561_SCREEN_MIPI_DSI_HSYNC, HI8561_SCREEN_MIPI_DSI_HBP,
                      HI8561_SCREEN_MIPI_DSI_HFP, HI8561_SCREEN_MIPI_DSI_VSYNC, HI8561_SCREEN_MIPI_DSI_VBP, HI8561_SCREEN_MIPI_DSI_VFP,
                      HI8561_SCREEN_BITS_PER_PIXEL_RGB565, mipi_dpi_panel) == false)
    {
        printf("Mipi_Dsi_Init fail\n");
        return false;
    }

    return true;
}

void Lvgl_Init(void)
{
    ESP_LOGI(TAG, "Initialize LVGL library");
    lv_init();
    // create a lvgl display
    lv_display_t *display = lv_display_create(HI8561_SCREEN_WIDTH, HI8561_SCREEN_HEIGHT);
    // associate the mipi panel handle to the display
    lv_display_set_user_data(display, screen_mipi_dpi_panel);
    // set color depth
    lv_display_set_color_format(display, LV_COLOR_FORMAT_RGB888);
    // create draw buffer
    void *buf1 = NULL;
    void *buf2 = NULL;
    ESP_LOGI(TAG, "Allocate separate LVGL draw buffers");
    // Note:
    // Keep the display buffer in **internal** RAM can speed up the UI because LVGL uses it a lot and it should have a fast access time
    // This example allocate the buffer from PSRAM mainly because we want to save the internal RAM
    size_t draw_buffer_sz = HI8561_SCREEN_WIDTH * HI8561_SCREEN_HEIGHT * sizeof(lv_color_t);
    buf1 = heap_caps_malloc(draw_buffer_sz, MALLOC_CAP_SPIRAM);
    assert(buf1);
    buf2 = heap_caps_malloc(draw_buffer_sz, MALLOC_CAP_SPIRAM);
    assert(buf2);
    // initialize LVGL draw buffers
    lv_display_set_buffers(display, buf1, buf2, draw_buffer_sz, LV_DISPLAY_RENDER_MODE_PARTIAL);
    // set the callback which can copy the rendered image to an area of the display
    lv_display_set_flush_cb(display, example_lvgl_flush_cb);

    lv_indev_t *indev = lv_indev_create();
    lv_indev_set_type(indev, LV_INDEV_TYPE_POINTER); /*Touchpad should have POINTER type*/
    lv_indev_set_read_cb(indev, my_touchpad_read);

    ESP_LOGI(TAG, "Register DPI panel event callback for LVGL flush ready notification");
    esp_lcd_dpi_panel_event_callbacks_t cbs = {
        .on_color_trans_done = example_notify_lvgl_flush_ready,
        .on_refresh_done = example_monitor_refresh_rate,
    };
    ESP_ERROR_CHECK(esp_lcd_dpi_panel_register_event_callbacks(screen_mipi_dpi_panel, &cbs, display));

    ESP_LOGI(TAG, "Use esp_timer as LVGL tick timer");
    const esp_timer_create_args_t lvgl_tick_timer_args = {
        .callback = &example_increase_lvgl_tick,
        .name = "lvgl_tick"};
    esp_timer_handle_t lvgl_tick_timer = NULL;
    ESP_ERROR_CHECK(esp_timer_create(&lvgl_tick_timer_args, &lvgl_tick_timer));
    ESP_ERROR_CHECK(esp_timer_start_periodic(lvgl_tick_timer, LVGL_TICK_PERIOD_MS * 1000));
}

extern "C" void app_main(void)
{
    printf("Ciallo\n");
    XL9535->begin();
    XL9535->pin_mode(XL9535_5_0_V_POWER_EN, Cpp_Bus_Driver::Xl95x5::Mode::OUTPUT);
    XL9535->pin_mode(XL9535_3_3_V_POWER_EN, Cpp_Bus_Driver::Xl95x5::Mode::OUTPUT);

    XL9535->pin_write(XL9535_5_0_V_POWER_EN, Cpp_Bus_Driver::Xl95x5::Value::HIGH);
    XL9535->pin_write(XL9535_3_3_V_POWER_EN, Cpp_Bus_Driver::Xl95x5::Value::LOW);

    vTaskDelay(pdMS_TO_TICKS(100));

    XL9535->pin_mode(XL9535_SCREEN_RST, Cpp_Bus_Driver::Xl95x5::Mode::OUTPUT);
    XL9535->pin_write(XL9535_SCREEN_RST, Cpp_Bus_Driver::Xl95x5::Value::HIGH);
    vTaskDelay(pdMS_TO_TICKS(100));
    XL9535->pin_write(XL9535_SCREEN_RST, Cpp_Bus_Driver::Xl95x5::Value::LOW);
    vTaskDelay(pdMS_TO_TICKS(100));
    XL9535->pin_write(XL9535_SCREEN_RST, Cpp_Bus_Driver::Xl95x5::Value::HIGH);

    // example_bsp_init_refresh_monitor_io();

    example_bsp_enable_dsi_phy_power();

    vTaskDelay(pdMS_TO_TICKS(1000));

    Screen_Init(&screen_mipi_dpi_panel);

    esp_err_t assert = esp_lcd_panel_reset(screen_mipi_dpi_panel);
    if (assert != ESP_OK)
    {
        printf("esp_lcd_panel_reset fail (error code: %#X)\n", assert);
    }
    assert = esp_lcd_panel_init(screen_mipi_dpi_panel);
    if (assert != ESP_OK)
    {
        printf("esp_lcd_panel_init fail (error code: %#X)\n", assert);
    }

    XL9535->pin_mode(XL9535_TOUCH_RST, Cpp_Bus_Driver::Xl95x5::Mode::OUTPUT);
    XL9535->pin_write(XL9535_TOUCH_RST, Cpp_Bus_Driver::Xl95x5::Value::HIGH);
    vTaskDelay(pdMS_TO_TICKS(100));
    XL9535->pin_write(XL9535_TOUCH_RST, Cpp_Bus_Driver::Xl95x5::Value::LOW);
    vTaskDelay(pdMS_TO_TICKS(100));
    XL9535->pin_write(XL9535_TOUCH_RST, Cpp_Bus_Driver::Xl95x5::Value::HIGH);

    ESP32P4->create_pwm(HI8561_SCREEN_BL, ledc_channel_t::LEDC_CHANNEL_0, 2000);

    vTaskDelay(pdMS_TO_TICKS(300));

    HI8561_T_Bus->_iic_bus_handle = XL9535_Bus->_iic_bus_handle;

    HI8561_T->begin();

    Lvgl_Init();

    ESP_LOGI(TAG, "Create LVGL task");
    xTaskCreate(example_lvgl_port_task, "LVGL", 4 * 1024, NULL, 2, NULL);

    lv_example_canvas_7();

    ESP32P4->start_pwm_gradient_time(100, 500);

    while (1)
    {
        if (esp_log_timestamp() > Cycle_Time)
        {
            Cpp_Bus_Driver::Hi8561_Touch::Touch_Point tp;

            if (HI8561_T->get_multiple_touch_point(tp) == true)
            {
                printf("touch finger: %d edge touch flag: %d\n", tp.finger_count, tp.edge_touch_flag);

                for (uint8_t i = 0; i < tp.info.size(); i++)
                {
                    printf("touch num [%d] x: %d y: %d p: %d\n", i + 1, tp.info[i].x, tp.info[i].y, tp.info[i].pressure_value);
                }
            }

            Cycle_Time = esp_log_timestamp() + 1000;
        }

        vTaskDelay(pdMS_TO_TICKS(10));
    }
}
