Xinyuan-LilyGO/T-Display-P4/(commit log)

2025-06-12 update project
    [partitions.csv]
2025-06-17 update IMU instructions
2025-06-20 modify the wallpaper_1_540x1168px wallpaper, add GPS positioning timer, and adjust the camera configuration macro definition
2025-06-20 Fix the BW_62500 display error in LoRa. Fix the error when LoRa sends 255 data packets incorrectly. Resolve the I2C freezing issue caused by conflicts between SPI and I2C tasks.
    [main.cpp]
2025-06-24 fixed the issue of reversed X-axis mirroring in the lvgl_9_ui camera example
    [main.cpp]
2025-07-05 fix the crash issue in the GPS coordinate reading program
    [main.cpp]
2025-07-07 fix the error of the t_display_p4_config pin
2025-07-08 update gt9895 driver
2025-07-23 update afe example
    [partitions.csv]
2025-07-25 update esp32c6_at
2025-07-28 modify ldo_mipi_phy to 1.8v voltage
2025-07-28 update esp_video
    [partitions.csv]
2025-07-28 change the pin xl9535_camera_en to xl9535_sky13453_vctl
2025-07-29 change the default antenna for lora to rf1
2025-07-30 modify interrupt_flag to Interrupt_Flag
2025-08-01 modify Interrupt_Flag location
2025-08-04 update the description of the ESP32-C6 auxiliary processor
2025-08-07 update compatible with simulated Arduino library arduino_cpp_bus_driver
2025-08-09 update partition
    [partitions_model.csv]
2025-08-09 update attachInterrupt
2026-03-05 update the new component library management and update afe
    [partitions_esp32p4.csv, partitions_esp32p4_model.csv]
2026-03-05 update esp32c6_at_host_sdio_uart
2026-03-05 update esp32c6_at_host_sdio_wifi
2026-03-12 fix screen macro definition configuration error
    [main.cpp]
2026-03-20 fix radiolib cc1101 and nrf24l01 reception failure errors
    [main.cpp]
2026-03-23 update idf_component.yml to adapt to BOARD_TYPE_T_DISPLAY_P4_KEYBOARD
2026-03-27 update ethernet power off test
2026-04-07 modify BOARD_VERSION_T_DISPLAY_P4_V1_1 to BOARD_VERSION_T_DISPLAY_P4_V2_0
2026-04-13 update es8311_sd_mp3 to add automatic matching of mp3 music sample rate functionality
2026-04-14 update the CPP_BUS_DRIVER_DEVELOPMENT_FRAMEWORK_ESPIDF framework so that I2S can freely modify the clock configuration functions set_clock_reconfig and set_channel_enable
2026-04-30 Modify the method of obtaining driver.chip()
2026-04-30 Fix the music playback lag issue in the lvgl_9_ui program on the CONFIG_BOARD_TYPE_T_DISPLAY_P4_KEYBOARD board
    [main.cpp]
2026-05-12 Refactor and rename BQ27220 fuel gauge driver
2026-05-14 Refactored the SX126x driver to provide a more complete, datasheet-aligned LoRa/GFSK configuration and send/receive status workflow
2026-05-20 docs: add MeshCore Multi-Tool firmware project plan
    - PROJECT_PLAN.md: comprehensive markdown documentation
    - PROJECT_PLAN.html: styled dark-themed HTML version for browser viewing
    Covers architecture, 8 app modules (MeshCore, Security Tools, Weather,
    Camera Surveillance, Music Player, Smart Home, Game Console, Radio Scanner),
    implementation phases, technical considerations, and dependencies.
2026-05-24 Update [esp32c6][network_adapter] firmware
2026-06-02 Fix the cc1101 communication failure issue
    [main.cpp]
2026-06-03 Fixed the issue of garbled data and incorrect byte count when transmitting with CC1101.
    [main.cpp]
2026-06-24 Update structure
    [H753.stp]
2026-07-15 Remove the sx1262 calls to the cpp_bus_driver library in the lilygo_device_driver library, and use usp_cpp_bus_driver as the driver instead.
2026-07-30 Fix the CMake compilation error.
    [main.cpp]
2026-08-06 docs(readme): document coprocessor UART verification
    Refs: #26
2026-08-07 docs(readme): add ESP32-P4 download-mode recovery steps
2026-08-16 docs: add keyboard battery safety and usage guidance
    - add battery safety notes for T-Display-P4-Keyboard
    - remind users to turn off the keyboard power switch when not in use
    - document external 18650 charger recovery for low-voltage protection
    - add a CC0 external charger reference image
    - update both English and Chinese READMEs
2026-08-31 docs: add MMCX antenna connector notes and image #28
2026-09-01 docs: add LoRa antenna switch truth table #28
2026-09-01 docs: add LoRa antenna switch truth table
2026-09-05 fix(examples): adapt examples to updated drivers and peripheral initialization
    - Update driver includes and board initialization across 12 examples
    - Migrate SX1262 LoRa and continuous-wave examples to the USP driver
    - Update GFSK reset handling and chip ID APIs
    - Add XL9535-backed DIO1 and reset control to the RadioLib example
    - Implement UART passthrough, Wi-Fi connection, and SNTP queries using updated ESP-AT APIs
    - Centralize ESP-AT transport and reconnection logic in libraries/common
    - Configure ES8311 playback and AFE capture modes, including 16 kHz clock setup and capture buffers
    - Explicitly enable Ethernet and USB Host power
    - Add the NFC driver submodule and update driver reference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
    [main.cpp]
2026-09-05 docs: correct keyboard battery type to 21700 (#27)
2026-09-05 fix(examples): adapt keyboard examples to updated device drivers
    - Update CC1101 and NRF24L01 RadioLib initialization and SPI ownership
    - Handle received packet lengths and debounce BOOT-triggered transmission
    - Adapt screen and keyboard input to runtime screen detection and current APIs
    - Set keyboard backlight to 50% with a one-second fade
    - Preserve NFC/NDEF functionality and isolate Arduino/native RFAL headers
    - Remove local standalone TCA8418 and XL9555 examples and menu entries
    [main.cpp, st25r3916_driver.cpp, st25r3916_driver.h]
2026-09-05 chore(deps): remove unused ICM20948_WE submodule
    - Remove icm20948_we submodule and component dependency
    - Drop the unused Arduino dependency from the screen keyboard example
2026-09-14 fix(screen): wake display after low-power initialization (#30)
    -explicitly exit sleep mode and disable screen-off state for Hi8561
    and RM69A10 panels before starting LVGL rendering
    [main.cpp]
2026-09-24 docs: add keyboard and battery schematics (#32)
2026-10-15 docs: add LR2021 schematics (#33)
2026-10-16 docs: add battery specification and V1.0 enclosure CAD
2026-10-16 docs: rename enclosure CAD to PCB CAD
2026-10-16 docs: update V2.0 schematic and hardware reference (#20)
2026-11-02 docs: Update k270 T-Display-P4-Keyboard_v1.0 enclosure 3D model (#36)
